rsheng1001-lang/WPT/LPspice_circuit/仿真结论_2026-09-21.md

# 输出端（接收端）恒流刺激电路 仿真结论

日期：2026-09-21
对象：`SCH_接收端原理图_2026-09-20.pdf`（v1.0，2026-09-20 版）中 V_BUS 之后的整条链路
仿真环境：LTspice 26.0.2，Windows；模型：TI OPAx333（原厂）、Diodes 2N7002（原厂）、
ST715/MCP1703AT/TVS（**自制近似模型，非原厂**）

一键复现：`cd ltspice && python run_all.py`

---

## 一、结论摘要

| 项目 | 结果 | 依据 |
|---|---|---|
| 恒流值 | **I(R10) = 99.999 µA**，负载支路 99.782 µA | 4 个工作点 + 连续扫描 |
| 恒流合规范围（典型件） | 1 kΩ ~ **76.7 kΩ**，即负载电压 ≤ **7.66 V** | `.dc` 连续扫描 |
| 恒流合规范围（计 FB 容差） | **73 k ~ 80 kΩ**（见第六节） | 数据手册 + 本仿真 |
| 合规边界所需压降 | 漏极余量 ≈ **0.345 V**（含 0.3 V 采样压降，即 Vds ≈ 45 mV） | 同上 |
| 跌出调节后的行为 | 恒压"饱和"：78.7 kΩ→98.2 µA，80 kΩ→96.5 µA，100 kΩ→78.0 µA | 同上 |
| 栅极驱动需求 | 100 µA 需 **2.478 V**，OPA333 实测最高输出 **3.271 V** | `.op` |
| 栅极驱动余量（最坏情况实测） | 仍余 **0.354 V**：Vth=2.5 V（规格上限）+ 3.3 V 轨下限 3.2 V 下仍正常恒流 | `core_gate_margin.cir` |
| 失效点 | **Vth ≈ 2.86 V**（实测 Vth=3.0 V 时电流只有 50.5 µA，即目标的一半） | `core_gate_cliff.cir` |
| 恒流值与 3.3 V 轨的关系 | **成比例**：I = V3V3/(11×3k)。轨压 3.2 V 时实测 96.97 µA（不是 100 µA） | 同上 |
| 上电行为 | **无电流过冲**（全程峰值 99.81 µA vs 终值 99.78 µA），10.2 ms 内进入 ±1% | 启动瞬态 |
| 母线总电流 | V_BUS=12 V 时 **164.8 µA**：灌电流 99.8 µA + 偏置 65.0 µA | 全母线扫描 |
| 8 V 轨起调点 | V_BUS ≥ **≈8.01 V** 起稳压（近似模型） | 全母线扫描 |
| 负载突变电流冲击 | 峰值 **634 µA（额定的 6.4 倍）**，但只持续 **0.5 µs**；净电荷偏差 < 0.6 nC | 负载阶跃 |

**总线电流自洽校验**：164.8 − 99.8 = 65.0 µA 偏置，与数据手册静态电流逐项相加
（FB 分压 12.0 + ST715 静态 3.8 + MCP1703 静态 2.0 + 核心分压 30.0 + OPA333 静态 17.0
= 64.8 µA）闭合到 0.2 µA。这是对网表和模型的一次独立交叉验证。

---

## 二、必须先说的：原厂 OPAx333 模型的求解器陷阱

这是上一轮工作卡住的地方，也是**使用本仿真结果前必须知道的前提**。

TI 的 OPAx333 宏模型是 Green-Williams-Lis 架构的电流模式网络，内部含开关（S 元件）、
TΩ 级节点（如 `R_R53 VCC_CLP MID 1T`）和巨大的跨导。它的直流方程组**存在多个解**，
其中一部分是物理上不可能的解（输出跑到供电轨之外）。实测：

| 求解路径 | V(OUTA) | V(I_SENSE) | 判断 |
|---|---|---|---|
| Gmin stepping 回退 | −5.21 V（低于 0 V 轨） | −0.0016 V | 伪解 |
| 冷启动 Newton | +8.51 V（高于 3.3 V 轨） | 1.75 V | 伪解 |
| 纯 Newton / 伪瞬态 | **2.480 V** | **0.300 V** | 物理解 |

三处具体后果，均已修正：

1. **`solver.inc`（新增）**：所有 deck 统一加 `.options gminsteps=0 srcsteps=0`，
   禁用 Gmin/source stepping 回退。回退注入的泄漏电流会把这颗模型的内部参考节点推偏。
2. **`.op` 负载表上限**：负载 ≥ 约 66 kΩ 时冷启动 `.op` 会落到伪解，因此
   `core_op.cir` 只保留 1k/10k/50k/65k 四个可信工作点；合规边界改用
   `.dc` 连续扫描（从 1 kΩ 起扫保证沿物理支路）在 `core_compliance.cir` 中测量。
3. **启动瞬态时长**：模型内部把参考节点挂在 `C_C14 = 5 µF` 对两个 1 MΩ 电阻上，
   时间常数约 **2.5 s**。因此 30 ms 的瞬态报出的是"内部参考尚未建立"的状态
   （这正是一度看到 V(OUTA) = −4.8 V 的原因），启动分析必须跑到 3 s。

**因此：任何用这颗模型得到的结果，都必须过一遍物理校验**（输出在供电轨内、
V(I_SENSE) = V(I_SET)、KCL 闭合）。本次所有结论都做了该校验。

---

## 三、文件结构

**要"看"电路，打开这两张图（LTspice 双击即可运行）：**

| 文件 | 内容 | 对应网表 |
|---|---|---|
| **`ltspice/full_bus.asc`** | 全链路 6 个模块，用**原厂** OPAx333 / 2N7002 + 自制近似稳压器 | `full_bus_dc.cir` |
| **`ltspice/sink_vendor.asc`** | 只有恒流沉三块，配理想 8 V/3.3 V 源 | `core_op.cir`、`core_startup.cir`、`core_reconnect.cir` |

不便开 LTspice 时可先看 `ltspice/preview/*.svg`（浏览器打开）。
顶层 `README.md` 有目录说明与一键复现方法。

```
输出端原理图/
  README.md                从哪开始、一键复现
  仿真结论_2026-09-21.md   ★ 本报告
  SCH_接收端原理图_2026-09-20.pdf   源图（嘉立创EDA v1.0）
  ltspice/
    full_bus.asc  sink_vendor.asc   ★ 原理图
    *.asy                           子电路符号（须与 .asc 同目录）
    *.net                           图导出的网表（LTspice 生成）
    decks/                          网表 deck（9 个 .cir）
      opa333_validation.cir    1. 原厂模型资格验证
      core_op.cir              2. 恒流沉直流工作点
      core_compliance.cir      3. 合规曲线（行为负载，连续扫描）
      core_startup.cir         4. 冷启动瞬态
      core_reconnect.cir       5. 负载阶跃瞬态
      full_bus_dc.cir          6. 全母线直流扫描
      core_gate_margin.cir     8. 栅极驱动最坏情况（Vth=2.5V，3.3V 轨下限）
      core_gate_cliff.cir      8. 同上但 Vth=3.0V（对照，应失效）
      tvs_compare.cir          8. TVS 近似模型 vs Vishay 官方库
    inc/                            sink / core / power / solver.inc
    models/                         OPAx333.LIB、2N7002_DIODES.lib（原厂）
                                    APPROX_NOT_VENDOR.lib（自制近似）
                                    2N7002_VTO25/VTO30.lib（Vth 敏感性变体）
    tools/                          make_schematic.py、compare_netlists.py、
                                    run_all.py、run_one.py、read_raw.py
    runs/                           仿真输出（.raw/.log/.db）
    preview/                        原理图预览 SVG
    summary.txt                     run_all.py 输出留档
  vendor/                  第三方资料：Vishay SPICE 库、数据手册、OPA333 原厂模型
  archive/                 早期 PDF 渲染截图
  self/                    你自己的草稿与下载（未纳入本工程）
```

一键复现：`cd ltspice && python tools/run_all.py`（跑 8 节，输出同时写入
`summary.txt`）。

### 原理图是怎么画和怎么验证的

上一轮只交付了网表（`.cir` 是纯文本，打开只能看到文字），本机也没有留下除
`Draft2.asc` 以外的图形文件。本轮补上了两张图，并做了三重验证：

1. **几何自检**（`make_schematic.py` 内置 + LTspice MCP 的 `verify_circuit`）：
   引脚是否落在导线上、有无悬空线头、导线是否穿过器件本体、有无意外交叉。
2. **网络一致性**：把图导出成权威网表，逐器件核对节点连接。
3. **数值等价**：跑图，把结果与 `.cir` 的结果逐个数字比对 ——
   `sink_vendor.asc` 相对误差 **9.7e-9**，`full_bus.asc` 全 49 个扫描点
   最大相对误差 **3.4e-7**（纯浮点噪声），即两张图与网表**是同一个电路**。
   这一步是必需的：第 1、2 步都查不出下面第 2 条的短路。

画图过程中被上述检查抓出并修正的错误（前两条会导致电路不等价）：

| # | 错误 | 后果 | 发现方式 |
|---|---|---|---|
| 1 | 生成 `OPAx333.asy` 时按 `SYMATTR Description` 截断文件，而 opamp2 的 PIN 定义在 Description **之后** | 运放符号没有引脚，四处悬空 | `verify_circuit` 报 dangling_wire_end |
| 2 | C13 的接地引脚落在 R8→STIM_GATE 导线的**内部**（同为 y=652，x=856 落在 840..904 之间） | **把栅极短路到地**，`STIM_GATE` 变成节点 0 | 数值比对（`V(stim_gate)` 消失、多出 `V(n001)`）；`verify_circuit` 不报此项，故自建检查器 |
| 3 | 移动后的 C13 本体框与 R_BONE→漏极的 BONE_N 导线重叠 | 仅视觉遮挡，电气无影响 | `verify_circuit` 报 wire_through_symbol |

**版式（2026-09-21 重排，按 PDF 分模块）**：两张图都按原 PDF 的功能划分画成
**6 个带边框的模块**，模块之间只用网络标签连接（PDF 也是这么画的）。
按要求**不放任何文字标注**（模块标题与说明段均已删除）：LTspice 按字节读 `.asc`，
非 ASCII 文字会显示为乱码，且会进入网表。

| 模块 | 内容 | 图 |
|---|---|---|
| 1 无线能量接收、补偿与整流滤波 | **未建模**（缺线圈与激励参数）：只有 V_BUS 激励源与 C5/C6 | 全链路 |
| 2 BONE 8V 稳压 | ST715 + R1/R2/R3 反馈 + C7/C8 + TVS D5 | 全链路 |
| 3 3.3V 参考电压 | MCP1703 + C9/C10 + R4（PGND↔GND 网络连接） | 全链路 |
| 4 恒流调节 | R5/R6/R7 + C12 | 两张 |
| 5 恒流控制 | OPA333 + C13/C14 + R8 | 两张 |
| 6 BONE负载 | Q1 + R9 + R10 + R_BONE | 两张 |

`full_bus.asc` 上排 1/2/3、下排 4/5/6；`sink_vendor.asc` 只含 4/5/6 并把理想
电源画进对应模块。

排布依据 LTspice 的实际行为（都是踩过坑才确认的）：

- **网络标签的文字方向跟随导线方向**——挂在竖直引脚上的标签会渲染成竖排文字。
  因此所有电源标签（V3V3 / PGND / BONE_P / BONE_N）都改走**水平短线**。
- **引脚画在方块外面时，引脚名会沿引脚方向旋转**。LTspice 自带的 `NE555.asy`
  把方块引脚放在方块边线上（零长度），引脚名就在方块内横排——本工程的方块符号
  改成同样写法。
- 水平电阻显式加 `WINDOW`（位号在上、阻值在下），因为 LTspice 默认会把两者叠在一起。
- **图必须写 `.save`**：不写的话 LTspice 会把宏模型的全部内部节点存进 `.raw`，
  一次 49 点的 `.dc` 扫描写出 156 MB、耗时 70 秒（写成 5 KB / 3 秒）。
- **`R_BONE` 要画在电流路径上**：它是骨/电极负载（BONE_P→组织→BONE_N），
  早期版本两端只用网络标签连接，看起来不像串在回路里；现在用实线从 BONE_P
  经 R_BONE 接到 MOSFET 漏极，只留一个 BONE_N 标签。
- **`.asc` 用 GBK 写，不用 UTF-8**：LTspice 按字节读 `.asc`，UTF-8 的中文会被
  当成多个字节写进网表并导致解析失败（实测报
  `Expected device instantiation or directive here`）。现已删除全部文字标注，
  但生成器仍按 GBK 写出，便于日后需要时再加文字。

**新增 `compare_netlists.py`**：把图导出的网表与 `.cir` 逐元件、逐节点比对。
数值等价只能说明"有差异"，这个工具能指出"差在哪个器件"。它在本轮抓出两处真错误：

| 错误 | 后果 | 发现方式 |
|---|---|---|
| 重排时漏掉 C5、C6、D5（TVS）三个器件 | 电路不完整 | 数值比对（相对差 6e-5） |
| **C5 的 PGND 短线与 C6 的 V_BUS 短线共线交叠** | V_BUS 与 PGND 短路（网表里 `VBUS PGND PGND`） | `compare_netlists.py` |

`make_schematic.py` 的几何自检也补上了"共线交叠"这一条。

**关于偶发不收敛**：同一份未改动的网表，正常 2 秒跑完，偶尔会走到伪瞬态支路后
步长崩塌、几分钟不推进（实测 `core_reconnect.cir` 一次 300 秒超时、随后三次复跑
均在 2 秒内完成且结果完全一致）。这是原厂宏模型直流求解的固有脆弱性，
`run_all.py` 现在会重试并在放弃时明确标注用的是哪一次的结果。
（另有一次 `full_bus.asc` 跑到 70 秒 / 156 MB，原因不同：那张图当时没写 `.save`，
与模型无关，已修正。）

### 本轮对上一轮文件的修正

| 文件 | 问题 | 处理 |
|---|---|---|
| `power.inc` | `R4 PGND 0 0` —— LTspice 拒绝字面 0 Ω，导致 `full_bus_dc.cir` **从未成功运行过** | 改为 1 mΩ 并注明图中原值就是 0 Ω（PGND↔GND 网络连接），压差为 µV 级 |
| `core.inc` | 负载与核心耦合在一个文件里，无法替换负载夹具 | 拆为 `sink.inc` + 负载，`core.inc` 保留兼容 |
| `core_op.cir` | 负载表含 ≥70 kΩ 点，冷 `.op` 报伪解 | 限制到可信区间，注明原因 |
| `core_startup.cir` | 30 ms 时长，报出未建立的内部参考状态 | 改为 3 s，并注明模型限制 |
| 各 deck | 继承伪解 | 统一加 `solver.inc` |

---

## 四、与原理图的逐点核对

已用 400 dpi 重渲染 PDF 并逐区放大核对，网表与图**完全一致**，包括容易搞错的几处：

- C14 = **100 pF**，跨接 OUTA ↔ I_SENSE（反馈电容，不是 100 nF）
- C13 = 100 nF（+3.3 V 去耦）、C12 = 100 nF（I_SET 滤波）
- R9 = 10 MΩ 接在 **STIM_GATE ↔ I_SENSE**（栅-源），不是栅-地
- Q1 = 2N7002：D→BONE_N，G→STIM_GATE，S→I_SENSE（与 Diodes 模型 `D G S` 顺序一致）
- U3 = OPA333AIDBVR：pin3=IN+←I_SET，pin4=IN−←I_SENSE，pin5=+3.3V，pin2=GND
- U1 = ST715CR：R1=560k / R2=6.8k / R3=100k，FB 取 R2-R3 中点 → 标称 8 V
- U2 = **MCP1703AT-3302E/CB**（不是 MCP1700A），VIN←BONE_P
- D5 = VESD16C1-02V-G3-08：阴极接 V_BUS、阳极接 PGND（反向击穿钳位，方向正确）
- 恒流设定：R5=100k / R7=10k → V(I_SET)=0.3 V，采样 R10=3 kΩ → **100 µA** ✓

---

## 五、各 deck 结果

### 1. `opa333_validation.cir` —— 原厂模型资格验证
单位增益跟随器，输入 0.1~3.2 V 直流扫描，最大 |V(out)−V(in)| = **0.336 µV**
（即模型的输入失调）。结论：模型在 LTspice 中的**差分行为正确**。
注意这一项**不能**证明直流支路唯一性（见第二节），两者互不替代。

### 2. `core_op.cir` —— 直流工作点

| RLOAD | I(R10) | V(I_SENSE) | V(OUTA) | V(BONE_N) | I(R_BONE) |
|---|---|---|---|---|---|
| 1 kΩ | 99.999 µA | 0.299998 V | 2.4798 V | 7.9018 V | 99.782 µA |
| 10 kΩ | 99.999 µA | 0.299998 V | 2.4798 V | 7.0038 V | 99.782 µA |
| 50 kΩ | 99.999 µA | 0.299998 V | 2.4798 V | 3.0125 V | 99.782 µA |
| 65 kΩ | 99.999 µA | 0.299998 V | 2.4798 V | 1.5158 V | 99.782 µA |

V(OUTA) 恒定 2.4798 V（因为 100 µA 所需的栅压与负载无关），全程在 0~3.3 V 轨内。
I(R10) 与 I(R_BONE) 相差 0.217 µA，正好等于流经 R9(10 MΩ) 的电流
（2.1776 V / 10 MΩ = 0.218 µA）—— **KCL 精确闭合**。

### 3. `core_compliance.cir` —— 合规曲线

| RLOAD | I(R10) | V(I_SENSE) | V(OUTA) | 状态 |
|---|---|---|---|---|
| 9.9 k ~ **76.7 kΩ** | **99.999 µA** | 0.299998 V | 2.4798 V | 恒流调节 |
| 78.7 kΩ | 98.203 µA | 0.294610 V | 3.2709 V | 饱和 |
| 80.2 kΩ | 96.456 µA | 0.289369 V | 3.2709 V | 饱和 |
| 90.1 kΩ | 86.232 µA | 0.258697 V | 3.2710 V | 饱和 |
| 100 kΩ | 77.978 µA | 0.233933 V | 3.2711 V | 饱和 |

边界点 V(BONE_N) = 0.3449 V → **负载电压上限 7.657 V**，即 100 µA 下
最大负载 76.7 kΩ。跌出调节后运放输出顶到 3.271 V（饱和），电流退化为
纯电阻限制 (V8 − 0.25)/(RLOAD + 3k)，这是"失效安全"的方向（电流变小）。

### 4. `core_startup.cir` —— 冷启动（RLOAD=10 kΩ，电源 1~2 ms 斜坡）

- 稳定值 99.782 µA；**全程峰值 99.814 µA，过冲仅 0.03%**
- V(OUTA) 全程 ∈ [−0.0051, 2.4799] V，未越轨
- 10.22 ms 内进入 ±1%
- 时序：V8 先到 8 V（1 ms），3.3 V 轨 2 ms 建立后环路才导通 → 上电期间
  负载上先出现 8 V 但**没有电流**，之后平滑爬升。**无上电电流冲击**。

### 5. `core_reconnect.cir` —— 负载阶跃（60 kΩ → 9.37 kΩ，t=5 ms）

- 阶跃前后均稳定在 99.782 µA
- **峰值 634.3 µA（6.4 倍额定）**，出现在阶跃后 0.51 µs
- 随后短暂反向：最低 −0.728 µA
- **超出 100 µA 的多余电荷仅 0.512 nC**；不足部分 4.361 nC
- 37.4 µs 内回到 ±2%，50 µs 后偏差 < 0.9 µA

即：电流冲击幅值高但极短，净电荷偏差 **亚 nC 级**（对比典型刺激脉冲 100 µA×100 µs
= 10 nC）。环路阻尼良好，无持续振荡。

### 6. `full_bus_dc.cir` —— 全母线（V_BUS 4~16 V，**近似**稳压器）

| V_BUS | BONE_P | +3.3 V | I_sink | I(V_BUS) |
|---|---|---|---|---|
| 4 V | 3.9991 V | 3.3000 V | 99.782 µA | −158.8 µA |
| 8 V | 7.9991 V | 3.3000 V | 99.782 µA | −164.8 µA |
| 8.5 V | 8.0016 V | 3.3000 V | 99.782 µA | −164.8 µA |
| 12 V | 8.0016 V | 3.3000 V | 99.782 µA | −164.8 µA |
| 16 V | 8.0016 V | 3.3000 V | 99.782 µA | −164.8 µA |

- 8 V 轨在 V_BUS ≥ ≈8.01 V 起稳压（近似模型压差仅 ~1 mV，真实 ST715 亦很小）
- 恒流值在整个 V_BUS 范围内不变
- 16 V 相对 12 V 的输入电流只多 2 nA → 近似 TVS 漏电可忽略

---

## 六、原厂模型 vs 近似模型（结论可信度分级）

| 器件 | 模型来源 | 可用于 |
|---|---|---|
| U3 OPA333 | **TI 原厂** | 直流、环路、瞬态（须过物理校验） |
| Q1 2N7002 | **Diodes 原厂** | 直流、开关 |
| U1 ST715CR | 自制近似 | **仅**连接性与直流可行性 |
| U2 MCP1703AT | 自制近似 | **仅**连接性与直流可行性 |
| D5 TVS | 自制近似 | **仅**连接性与直流可行性 |
| D1–D4 整流桥、C1–C4 补偿 | **未建模** | — |

---

## 七、官方模型可得性核查（2026-09-21）

| 器件 | 官方 SPICE 模型 | 证据 / 文件 |
|---|---|---|
| U1 ST715CR | **没有** | ST 该料号页面只有 "EDA Symbols, Footprints and 3D Models"（Ultra Librarian / SamacSys）。ST 的 SPICE 库（97 条）全是功率器件/运放，**没有任何 LDO**；抽查 6 个 ST LDO 产品页，"spice" 出现 0 次。ST 的仿真工具（eDSim/TwisterSim/TVS Simulator）均不覆盖线性稳压器。 |
| U2 MCP1703AT | **有** | Microchip **MPLAB Mindi "Analog Simulation"** 库：`MCP1703A-33_Startup.zip`、`MCP1703A-33_Transient.zip`（2020-08-17），共 16 个文件按输出电压分档。<br>`microchip.com/en-us/software-library/analogsimmcp1703a`<br>注意：**免登录但需过 EULA 点击**；格式是 **SIMetrix/SIMPLIS 工程**而非通用 `.LIB`；按输出电压分档、**不区分封装**。本机自动下载被 HTTP 403 拦截。 |
| D5 VESD16C1-02V | **部分有** | 精确的 **-02V（SOD-523）无模型**，该料号页面只有 Ultra Librarian 的符号/封装/3D。<br>但 Vishay 发布覆盖 `VESD16C1` 的**明文 SPICE 库**（文件头声明适用范围为 `-HD1`，即 SOD-323 封装）：<br>`vishay.com/docs/86547/spice_vishay_vesd01c1-hd1-to-vesd33c1-hd1.zip`（2022-02，已下载并核实，见 `ltspice/vendor/vishay/`）。<br>模型内容：`D1 1 2 DF`，`BV=17.7 V / IBV=10 µA / CJO=27 pF`，引脚 1=阳极、2=阴极。 |

**对本次结论的实际影响（已实测，见 `tvs_compare.cir`）**：
- **TVS 的直流结论不变**：12 V 工作点上漏电 近似模型 7.5 nA vs 官方模型 0.024 nA，
  相差 7.5 nA，只有母线电流（165 µA）的 **0.0045%** → 全部直流结论不受影响。
- **但钳位拐点不可互换**（这一条推翻了本报告上一版的说法）：官方模型 1 µA 出现在
  **17.75 V**、1 A 出现在 **18.5 V**；近似模型分别是 **18.0 V / 20.0 V**。
  19 V 下两者电流差 **4 倍**（0.53 A vs 2.09 A），等效钳位阻抗约 2.06 Ω vs 0.5 Ω。
  **做浪涌/ESD 分析必须用官方模型**；封装差异（库声明适用于 -HD1/SOD-323，
  板上是 -02V/SOD-523）仍需标注。
- **MCP1703A**：官方模型的价值在 **启动与负载瞬态**——正是现有近似模型不具备、
  也是本次报告明确标记"未验证"的两项。但它是 SIMetrix/SIMPLIS 工程，
  **不能直接喂给 LTspice**；正确做法是用免费的 **MPLAB Mindi** 单独跑这两项。
- **ST715**：任何来源都没有模型。这是硬缺口，只能靠实测或换料解决。

---

## 八、数据手册核对（不依赖模型的独立检查）

用 ST715 DS5704 Rev 16（2025-03）、MCP1703A DS20005122C 复核，发现 4 条与设计直接相关的条文：

1. **8 V 轨实际容差远大于仿真的 8.0016 V。** 可调版 FB 基准 V_FB 的容差为
   1.195~1.245 V（0~85 °C）/ 1.152~1.248 V（−40~125 °C），
   而 V_OUT = V_FB × (1 + 566.8k/100k) = 6.668 × V_FB。折合：
   - 0~85 °C：**7.97 ~ 8.30 V**
   - 全温区：**7.68 ~ 8.32 V**

   代入合规边界 V(BONE_N) = 0.345 V，100 µA 下最大负载相应为
   **73.4 k ~ 79.8 kΩ**（本报告第一节的 76.7 kΩ 是典型值）。
   （R1/R2/R3 自身容差与温漂会在此基础上再加。）

2. **ST715 可调版的精度规格只在 I_OUT ≥ 1 mA 下保证，本设计负载只有约 165 µA。**
   手册 Table 6 的 V_FB 精度与负载调整率**都带 1 mA 下限**；
   而**固定输出版（Table 7）是从 0 mA 起**给规格的。
   即：8 V 的精度落在保证范围之外——不是"已知不达标"，而是"未承诺"。
   建议按第 2 条实测轻载下的实际输出。

3. **C8 = 0.47 µF 正好卡在 ST715 输出电容的下限。** 手册要求 C_OUT ≥ 0.47 µF
   （"from 0.47 µF to 10 µF"），无余量；且 Figure 9 的稳定性区域图里，
   低 ESR 陶瓷电容在 0.47 µF 处落在 "Untested area"。
   建议加大到 1 µF 以上再评估。

4. **U2 的输入/输出电容比例不符合手册建议。** MCP1703A 要求
   "C_IN 应 ≥ C_OUT"（用于动态负载时给输出电容补能），且典型应用建议 C_IN = 1 µF。
   本设计 C9 = 100 nF、C10 = 1 µF（C10 本身合规：1~22 µF 陶瓷范围的下限）。
   虽然手册允许负载 < 100 mA 时降低 C_IN，但建议把 C9 提到 1 µF。
   另：MCP1703A 输出上升时间 600 µs 典型且"controlled to prevent overshoot"，
   支持 3.3 V 轨无上电过冲的判断。

（输入电容 C7 = 100 nF 与 ST715 手册推荐的 0.1 µF 及特性化条件一致，无需改动。）

---

## 九、本次仿真**不能**得出的结论（明确边界）

1. **无线供电性能**：接收线圈电感/电阻、工作频率、激励参数从未提供，整流前端
   （D1–D4、C1–C4、C5/C6）未建模，`full_bus_dc.cir` 从 V_BUS 起算。因此
   **不能**得出接收功率、效率、V_BUS 建立时间等任何结论。
2. **稳压器性能**：ST715/MCP1703 是自制近似模型，**没有**环路稳定性、启动过冲、
   PSRR、过流/过温保护、反向电流保护等行为。带真实模型前不能判定 LDO 稳定性。
3. **真实电极负载**：RLOAD 是测试电阻。真实电极-组织界面有容性分量，
   高频阻抗远低于电阻模型；脉冲边沿行为需实际阻抗模型。
4. **温度、容差、批次**：无温度扫描、无容差/Monte Carlo 分析。特别是栅极驱动余量
   0.79 V 依赖 Vth ≤ 2.95 V，建议对 Vth 上限件做实测确认。
5. **ESD/浪涌**：TVS 近似模型不是经验证的 ESD 模型，不能用于 ESD 等级判定。
   换用 Vishay 官方 VESD 库后可以先做连接性/钳位分析，但该库声明适用于
   `-HD1`（SOD-323）封装，与图上的 `-02V`（SOD-523）不同封装，浪涌行为仍不可断言。
6. **启动仿真限制**：负载 ≥ 约 50 kΩ 时该原厂模型的 t=0 工作点本身即伪解，
   瞬态无法推进，故重载启动未报告。
7. **LDO 的启动与负载瞬态**：Microchip 官方模型（`MCP1703A-33_Startup/Transient`）
   存在但为 SIMetrix/SIMPLIS 工程，未纳入本次仿真；ST715 无任何模型。

---

## 十、最坏情况与模型替换核查（2026-09-21 补充）

| 检查 | 方法 | 结果 |
|---|---|---|
| 栅极驱动最坏情况 | `core_gate_margin.cir`：MOSFET Vth 取数据手册上限 2.5 V，3.3 V 轨取下限 3.2 V，逐负载独立 `.op` | **仍正常恒流**：V(I_SENSE) 与 V(I_SET) 相差 0.6 µV，V(OUTA)=2.8167 V，距运放上限 3.171 V 还有 **0.354 V** |
| 失效边界（对照） | `core_gate_cliff.cir`：同上但 Vth=3.0 V（超出规格） | **不恒流**：电流只有 50.5 µA，V(OUTA) 顶到 3.171 V（栅极驱动耗尽） |
| 由此外推 | — | 本设计可容忍 Vth 高至约 **2.86 V**，高于 2N7002 规格上限 2.5 V |
| TVS 模型替换 | `tvs_compare.cir`：近似模型与 Vishay 官方库并排扫 0~25 V | 漏电 7.5 nA vs 0.024 nA（直流结论不变）；钳位拐点 17.75/18.5 V vs 18.0/20.0 V（**不可互换**） |

MOSFET 的 Vth 变体（`models/2N7002_VTO25.lib`、`_VTO30.lib`）是**敏感性分析用的变体，
不是厂商模型**：只改了 VTO，其余文本与 Diodes 原厂模型逐字相同，文件头已声明。

**一个独立发现**：恒流设定值是从 3.3 V 轨分压得到的，因此
**I_out = V3V3 / (11 × 3 kΩ)**——电流与 3.3 V 轨成比例，没有独立基准。
实测：轨压 3.3 V → 100.0 µA；轨压 3.2 V → 96.97 µA。
即电流精度 = LDO 输出精度 + R5/R6/R7/R10 容差。若需要更准的刺激电流，
应把 I_SET 改为由独立基准（如 OPA333 之外的基准源）产生，而不是取自 3.3 V 轨。

---

## 十一、建议的下一步

1. **实测 ST715CR 在 ~165 µA 轻载下的 8 V 实际输出与启动波形。** 这是唯一能闭合
   的项目：可调版的精度规格（V_FB、负载调整率）只保证 I_OUT ≥ 1 mA，
   而本设计负载低一个数量级，无模型可依（见第八节第 1、2 条）。
2. **电容两处调整**：C8 由 0.47 µF 提到 ≥1 µF（现正好卡在 ST715 下限且落在
   手册稳定性图的 "Untested area"）；C9 由 100 nF 提到 1 µF（MCP1703A 要求
   C_IN ≥ C_OUT）。
3. **用免费的 MPLAB Mindi + Microchip 官方模型单独跑 MCP1703A 的启动与负载瞬态**，
   可闭合现在标记为"未验证"的 3.3 V 轨软启动（手册标称 600 µs、无过冲）。
4. **合规上限按 73~80 kΩ 规划**（不是仿真给出的 76.7 kΩ 典型值），
   或在固件/硬件上限制最大负载电压 ≤ 7.6 V。
5. 提供接收线圈参数与激励，才能把整流前端纳入仿真。
6. 用实测电极阻抗替换 RLOAD 复跑第 3、5 节。
7. Vth 上限件（2.5 V）实测栅压需求，确认 0.79 V 余量。
8. 若做浪涌/ESD 分析，换用已下载的 Vishay 官方 VESD 库
   （`ltspice/vendor/vishay/`），并标注封装差异。
