rsheng1001-lang/WPT/self_LPspice/bone_sweep_analysis/figures/fig4_rmax_heatmap.pdf

## a Maximum BONE load, Rmax (kΩ), at a ±1.5 % budget

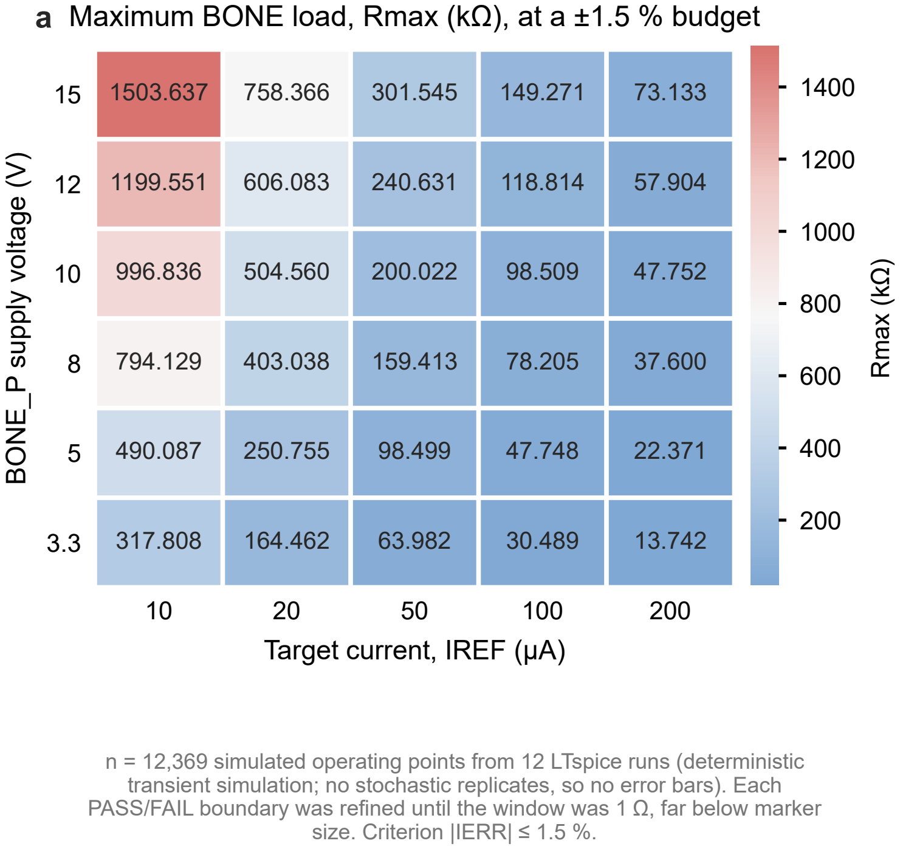
[picture p6: page 1]

10 | 20 | 50 | 100 | 200

### Target current, IREF (µA)

15

12

10

8

5

3.3

### BONE_P supply voltage (V)

1503.637 | 758.366 | 301.545 | 149.271 | 73.133
1199.551 | 606.083 | 240.631 | 118.814 | 57.904
996.836 | 504.560 | 200.022 | 98.509 | 47.752
794.129 | 403.038 | 159.413 | 78.205 | 37.600
490.087 | 250.755 | 98.499 | 47.748 | 22.371
317.808 | 164.462 | 63.982 | 30.489 | 13.742

200

400

600

800

1000

1200

1400

Rmax (kΩ)

n = 12,369 simulated operating points from 12 LTspice runs (deterministic transient simulation; no stochastic replicates, so no error bars). Each PASS/FAIL boundary was refined until the window was 1 Ω, far below marker size. Criterion |IERR| ≤ 1.5 %.
