rsheng1001-lang/WPT/self_LPspice/bone_sweep_analysis/README.md

# BONE_P 恒流源 — LTspice 三参数扫描分析（判据 ±1.5%，30/30 组合已精细定界）

本文件夹是 `Draft2` 三参数扫描（VBP × IREF × RB）的完整分析产物，与 LTspice 工程文件分离存放。
原始仿真输出（日志、网表、波形）归档在同级的 `../runs_archive/`，机制见文末「关于日志被覆盖」。

## 目录结构

```
bone_sweep_analysis/
├── Draft2_BONE_sweep_analysis.xlsx   ← 最终交付：8 个工作表 + 7 张图表（全部扫描合并）
├── README.md                          ← 本文件
├── scripts/                           ← 流水线
│   ├── ingest.py                      ★ 自动抓取新扫描入库（跑完直接一条命令）
│   ├── refine.py                      ★ 循环精细化扫描（自动改 RB 区间/步长 → 跑 → 入库 → 收敛）
│   ├── archive_run.py                 ★ 把一次运行的全部输出（含 .raw 波形）归档到 ../runs_archive/
│   ├── build_xlsx.py                  生成 Excel（公式 + 条件格式 + 图表）
│   ├── verify_xlsx.py                 用 Excel 重算并逐格比对真值，导出图表 PNG
│   ├── check_delivered.py             直接审计交付 .xlsx 的 XML
│   ├── parse_sweep.py                 通用解析器（ingest.py 内部复用）
│   ├── parse_draft2.py / parse_sweep2.py   历史脚本（早期单次解析）
│   ├── merge_sweeps.py                历史脚本（早期合并；现由 ingest.py 承担）
│   └── analyze_draft2.py              控制台版分析（Rmax / 临界区 / 10 µA）
├── work/                              ← 数据仓库
│   ├── manifest.json                  已入库扫描的登记表（签名 / 日志快照 / 统计）
│   ├── sweeps/sweep_<签名>.json        每次扫描的解析结果（永久保存）
│   ├── logs/<时间戳>_<日志名>.log      每次扫描的**原始日志快照**
│   ├── parsed_combined.json           所有扫描的并集（按 VBP→IREF→RB 排序，去重）
│   └── ground_truth.json              独立真值 + 表格布局行号（供校验）
├── charts/                            ← Excel 内嵌图表的 PNG 导出（7 张，工作簿用）
├── figures/                           ← ★ 出版级图表（nature-figure 技能产出）
│   ├── fig1_rmax_design_rule.{svg,pdf,tiff}    设计规则 + 验证（3 面板）
│   ├── fig2_compliance_limit.{svg,pdf,tiff}    ±1.5% 顺从极限（6 面板，按电源轨）
│   ├── fig3_transfer_characteristic.{svg,pdf,tiff}  原始传输特性（6 面板）
│   ├── fig4_rmax_heatmap.{svg,pdf,tiff}        Rmax 查找矩阵（单栏 89 mm，热力图）
│   ├── fig_source_rmax.csv            Fig.1 源数据
│   ├── QA_NOTES.md                    图契约、统计口径、QA 链结果、已修缺陷记录
│   └── make_figures.py                绘图源码
├── archive/                           ← 上一版（仅扫描 A）的工作簿，留档
└── restore/                           ← 2026-09-21 模型恢复过程与验证记录
    └── RESTORE_NOTES.md
```

## 三次扫描

| | 日志 | RB 范围 | 步长 | 分辨率 | 组数 | PASS=1 |
|---|---|---|---|---|---|---|
| **A** | `../Draft2.log` | 10 kΩ … 200 kΩ | 1 kΩ（191 点） | **1 kΩ** | 5730 | 2628 |
| **B** | `../Draft2_sweep.log` | 200 kΩ … 1000 kΩ | 10 kΩ（81 点） | **10 kΩ** | 2430 | 169 |
| **C** | `../Draft2_sweep.log` | 1 MΩ … 10 MΩ | 100 kΩ（91 点） | **100 kΩ** | 2730 | **0** |
| **refine ×9** | `refine.py` 生成 | 各临界窗口 | 1 kΩ→100 Ω→10 Ω→1 Ω | 逐轮收紧 | 1881 | — |

> refine 系列共 9 条记录（先按 1% 判据收敛 24 个窗口，改判据后又把 30 个窗口各收敛一轮）。
> 当前共 **12 条扫描记录、12369 行、1828 个 RB 取值**。

其余指令各次相同：`IREF list 10u 20u 50u 100u 200u`、`VBP list 3.3 5 8 10 12 15`、
`.tran 15m startup`，稳态测量区间 **12 ms ~ 15 ms**。

**重叠点交叉验证**：A/B 在 200 kΩ、B/C 在 1 MΩ 处重叠。两个重叠点各 30 个组合逐点比对，
IBONE 与 IERR **逐位完全一致**（最大相对偏差 0.00e+00）——证明三次运行是同一电路、同一模型。
重叠点合并时只保留一行（取自较早的扫描）。合并后 **12369 组**，1828 个 RB 取值，
无缺失、无重复。

## 日常流程（新扫描跑完后）

LTspice 每跑完一次，直接：

```bash
cd scripts
python archive_run.py     # 先归档：波形/网表/日志整个搬进 ../runs_archive/（幂等）
python ingest.py          # 自动找最新的完整日志 → 抓取入库
python build_xlsx.py      # 更新 Excel
python verify_xlsx.py     # 重算 + 逐格校验（可选，但建议）
```

**`archive_run.py` 放在第一步**：它会把这次运行的 `.log/.net/.raw/.op.raw/.db/.asc` 整体归档，
其中 `.raw` 默认是**移动**（工程根目录不再保留，LTspice 下次运行会重新生成）。换扫描参数前跑一次，
就再也不会出现扫描 B 那种"波形被下一次运行覆盖"的损失。细节见 `../runs_archive/README.md`。

`ingest.py` 会自动完成：

1. **自动挑选**工程目录里最新的日志（也可 `python ingest.py <路径>` 指定）；
2. **判断是否跑完**：四个 `.meas` 段齐全、行数等于 `.step` 行数、且文件静置 20 s 以上
   （没跑完就拒绝入库并提示）；
3. **校验**：step↔measurement 配对（用 `VBONE/IBONE` 反算 RB）、`PASS == (IERR<=1)`、
   组合无重复无缺失；
4. **快照原始日志**到 `work/logs/`，把解析结果存到 `work/sweeps/`，登记进 `work/manifest.json`；
5. 若该扫描**已入库**（按"实际跑过的 (VBP,IREF,RB) 集合"的签名判定），会逐位比对并刷新，
   **不会产生重复行**；
6. 重建 `work/parsed_combined.json`（所有扫描的并集）。

之后 `build_xlsx.py` 会自动把新扫描纳入：`Raw_Data` 增加 `Sweep`/`Source_Log` 列标注来源、
README 页自动列出每次扫描、图表自动扩展到新数据范围——**无需改代码**。

`python ingest.py --list` 可查看当前已入库的扫描清单。

### 为什么不用你管文件名

日志里的 `.step` 行是**每次运行的展开值**（几千行），真正的 `.step` 指令只存在于 `.net` 里。
所以入库身份用的是"这次实际跑了哪些 (VBP, IREF, RB)"的签名，与文件名无关；
每次抓取还会把原始日志**快照**下来，因此后续同名日志被覆盖也不影响已入库的数据。

## 判据阈值（可配置）

PASS 是 `IERR` 的纯函数，而 IERR 已按全精度存库，所以**改阈值不需要重跑任何仿真**。

| 位置 | 作用 |
|---|---|
| `scripts/config.py` → `IERR_MAX_PCT` | 决定 `refine.py` 的边界定位与写入工作簿的阈值 |
| 工作簿 `Rmax_Summary` 的「PASS 判据 IERR ≤ (%)」单元格 | `Raw_Data` 的 PASS 列是引用该格的活公式，改这一格全表重算 |

**当前阈值 ±1.5%。** 注意 LTspice 网表里的 `.meas PASS` 仍是 1% 判据（保留作为 IERR
解析正确性的校验），因此 `Raw_Data` 的 PASS 列与日志自身的 PASS 可能不同——工作簿 README
页 §4 已写明。改阈值的动作：改 `config.py` → `ingest.py` → `refine.py`（重新收敛边界）
→ `build_xlsx.py` → `verify_xlsx.py`。

## 精细化扫描（refine.py）

粗扫把每个临界值定位到当时扫描的分辨率（低阻段 1 kΩ、高阻段 10 kΩ）。`refine.py` 自动把它
收敛到工程可用的精度：

```bash
cd scripts
python refine.py                  # 目标：每个窗口 <= 10 Ω（默认）
python refine.py --target 1       # 更细：1 Ω（本次已跑到这一级）
python refine.py --parallel 6 --points 11 --max-rounds 6
```

每一轮它做四件事：

1. 从已入库数据算出每个 (VBP,IREF) 的 `lastPASS`/`firstFAIL` 窗口；
2. 对窗口仍大于目标的组合，**自动改 RB 区间与步长**（11 点等分窗口）并生成一个 deck；
3. 并行调用 `LTspice.exe -b` 跑完，解析日志、校验后**入库**（每轮成为 manifest 里的一条扫描记录）；
4. 重新定位窗口，继续下一轮，直到全部收敛。

实测：24 个临界窗口 × 11 点 = 264 组，**约 10 秒**跑完一轮。

**结论：24/24 收敛到 1 Ω**（相对约 100 kΩ 即 0.001%）。且每个 `lastPASS` 处的 IERR 都在
0.99%~1.00%，说明收敛到的正是 ±1% 阈值的真实交点。

### 踩过的两个坑（写在这里避免重复）

- **LTspice 26 不接受单值 `.step`**：`.step param IREF list 20u` 会报
  "This results in only one step" 并以退出码 1 终止、不产生任何输出。
  精细化 deck 因此把 IREF/VBP 用 `.param` 固定，**只对 RB 做 `.step`**。
- 这些 deck 的日志里只有 `.step rb=<值>`，没有三参数形式，所以 `refine.py` 用专门的
  解析路径（step 顺序 = RB 顺序），不能直接套用整扫的解析器。
## 出版级图表（figures/，nature-figure 技能）

```bash
cd figures
PYTHONPATH="<nature-figure>/scripts" python make_figures.py   # 重画并跑对齐门
# 然后按 QA_NOTES.md 里的命令跑字形下限与碰撞审计
```

四张图，可编辑文本，SVG + PDF + TIFF(600 dpi)：

| 图 | 内容 | 面板角色 |
|---|---|---|
| Fig. 1 | 设计规则 | a 主图 Rmax vs 电源电压；b 与解析式的 parity 验证；c 公式失效边界（10 µA） |
| Fig. 2 | ±1.5% 顺从极限 | a–f 每个电源轨一张，预算虚线上用 ▼ 标出各电流的 Rmax |
| Fig. 3 | 原始传输特性 | a–f 每个电源轨一张（用户指定轴：电流 vs 负载电阻） |
| Fig. 4 | Rmax 查找矩阵 | a 热力图：行=电源电压、列=目标电流、格内为 Rmax（**3 位小数**），蓝-白-红发散色阶 + colorbar（单栏 89 mm）。**两轴均从小到大**（3.3 V 在底部、10 µA 在左侧） |

**QA 链（全部在最终渲染上通过）**：源预检 20 pass/1 warn/0 fail；对齐门 **PASS**×3
（Fig.4 单面板为 NOT APPLICABLE，符合契约）；字形下限 **PASS**×4（最小 5.6 pt）；
PDF 碰撞审计 **PASS**×4（0 fail/0 warn）；页面实测 183.0 mm ×3、89.0 mm ×1。
Fig.4 的单元格文字对比度实测 4.72–13.91:1（30 格全部 ≥4.5:1）；30 个格值与原始
last-PASS 电阻**逐个精确相等**（无四舍五入、无插值、无平滑）。唯一的 warn 是静态检查器读不出命名常量里的宽度，已用 PDF 实测澄清。

过程中修掉 9 个缺陷，其中**一个是真实的数据错误**：Fig.3 曾用 `IERR × IREF / 100` 反算电流，
而 IERR 是相对误差，导致差了 **732 倍**（曲线从 0 升起而非恒流平台）——这类错误只有逐面板目视
才能发现，自动化检查全部通过。详见 `figures/QA_NOTES.md`。

## ⚠ 关于日志被覆盖（已有对策）

三次扫描都从同一个 `../Draft2_sweep.asc` 运行，因此**每次运行都会覆盖**上一轮的
`Draft2_sweep.log/.raw/.net`。

- 扫描 B 的原始日志与波形数据（398 MB `.raw`）**已被扫描 C 覆盖，无法找回**；
  仅剩解析后的 2430 组数据（`work/sweeps/` 内）作为记录。这是唯一一次损失。
- 扫描 A 与 C 的原始日志**已快照**到 `work/logs/`（`ingest.py` 对每次入库的扫描自动做）。
- **扫描 A 与 C 的完整运行（含 926.7 MB / 428.1 MB 波形）现已归档**到
  `../runs_archive/`，不再受根目录覆盖影响。

**现在的机制**：`python scripts/archive_run.py` 把工程根目录里所有尚未归档的运行整个搬进
`../runs_archive/<时间戳>_<名字>_<签名>/`（日志、网表、原理图、工作点、`.db`、`.raw` 波形 +
`meta.json` 含每个文件的 sha256）。按"名字 + 日志 sha256"判重，**幂等**，重复执行无副作用；
未跑完的扫描（同一套完整性判据）会被拒绝归档。**换扫描参数前跑一次即可。**

归档时还会顺带核对一件本工程反复踩到的事：**旁边的 `.asc` 往往不是产生这份日志的那一版**
（LTspice 改指令不存盘时，`.asc` 留在旧版本而 `.net` 已是新的）。脚本会把 `.asc` 的指令与
`.net` 逐条比对，把结论写进 `meta.json`，并在能找到真正匹配的原理图时一并归档。
已归档的两次运行的结论都是"同名 `.asc` 不匹配"——**要复现某次运行，以归档里的 `.net` 为准。**

`refine.py` 生成的精细化 deck 不需要额外归档：它们本来就在 `refine/decks_<时间戳>/` 里每轮一个独立文件夹。

## 校验状态

- `verify_xlsx.py`：**775/775 项通过**（Excel COM 强制全量重算后与 Python 独立真值逐格比对，
  含 Rmax 矩阵、临界区、精度矩阵、图表系列数、条件格式、命名区域，以及保存后的结构复核）
- `check_delivered.py`：**PASS**（XML 层面的冻结窗格、自动筛选、2 条 PASS 条件格式、
  定点数字格式、公式缓存值均在）
- 解析匹配的独立证据：每行用 `VBONE/IBONE` 反算 RB，与日志 `.step` 的最大相对误差
  **4.8e-07（A）/ 6.2e-08（B）/ 5.9e-08（C）**
- 重叠点 A/B 与 B/C 各 30 组逐位一致（见上）

## 结果要点

**判据 ±1.5%：30/30 组合全部测得真实临界值，且全部收敛到 1 Ω 窗口。**

| BONE_P / V | 10 µA | 20 µA | 50 µA | 100 µA | 200 µA |
|---|---|---|---|---|---|
| 3.3 | 317.808 | 164.462 | 63.982 | 30.489 | 13.742 |
| 5 | 490.087 | 250.755 | 98.499 | 47.748 | 22.371 |
| 8 | 794.129 | 403.038 | 159.413 | 78.205 | 37.600 |
| 10 | 996.836 | 504.560 | 200.022 | 98.509 | 47.752 |
| 12 | 1199.551 | 606.083 | 240.631 | 118.814 | 57.904 |
| 15 | 1503.637 | 758.366 | 301.545 | 149.271 | 73.133 |

单位 kΩ，每个值的窗口为 1 Ω（约 0.001%）。

**收敛自检**：每个 `lastPASS` 处的 IERR 都落在 **1.4990%~1.5000%**、`firstFAIL` 处
1.5000%~1.5050% —— 说明 1 Ω 网格正好咬住 ±1.5% 的真实交点，不是数值噪声。

**推荐设计公式**：`Rmax ≈ VBP / ((1 − T/100) × IREF) − R10`（T = 阈值 %，R10 = 3 kΩ）

- 目标电流 **≥20 µA**：平均偏差仅 **0.015%~0.031%**，可直接用于设计
- **10 µA：该式失效**（平均 2.15%、最大 4.28%）—— 其低负载基础误差已达 1.30%，
  距 1.5% 只剩约 0.2% 余量，拐点几乎与顺从电压拐点重合，一阶模型不成立；此情形请直接用表中实测值
- 公式来历：边界处电流已跌落约 T%，负载可用电压由这个已跌落的电流决定，故 R = V/I
  比用 IREF 算大约 T%（1% 判据下该式把偏差从 0.985% 降到 0.063%）

## 需要注意的已知限制

- 临界值已在 1 Ω 窗口内收敛；**非临界区域仍是原始粗分辨率**（1 kΩ / 10 kΩ / 100 kΩ 分段），
  这是有意的——只有临界窗口需要精细定位。
- 10 µA 的 1.5% 判据余量极小（0.198%），其临界值对电路参数变化最敏感；
  若电路改动（如运放失调变化），10 µA 行会最先变化。
- 全程未对缺失点插值或补数；图表只连接真实仿真点。
- 本机 Excel 实测**不支持 MAXIFS/MINIFS**，公式已改用 `LOOKUP` / `SUMPRODUCT` 兼容写法。
- 扫描 B/C 由恢复的 `../Draft2_sweep.asc` **起步**运行；该原理图为**重建版**（网表已验证等价，
  见 `restore/RESTORE_NOTES.md`）。但运行时的 `.step` 指令是在 LTspice 内存里改的、**没有存盘**：
  磁盘上那张 `.asc` 至今写着 B 段的 `RB 10k 200k 1k`，而 C 段实际跑的 `.net` 是
  `RB 1Meg 10Meg 100k`。**要复现某次运行，以 `../runs_archive/` 里对应文件夹的 `.net` 为准**
  （归档时已逐条比对并记录在 `meta.json` 的 `schematic` 段）。

详细说明（数据来源、判据定义、失效机理、验证结果）见 xlsx 的第一个工作表 `README`。
