rsheng1001-lang/WPT/FPC线圈叠层图/inputs/GND/GND.pdf

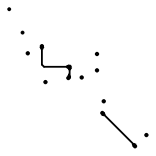
[picture p7: figure]
