rsheng1001-lang/WPT/FPC线圈叠层图/inputs/POWER/POWER.pdf

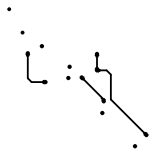
[picture p8: figure]
