rsheng1001-lang/WPT/FPC线圈叠层图/inputs/板框/Multi-Layer.pdf

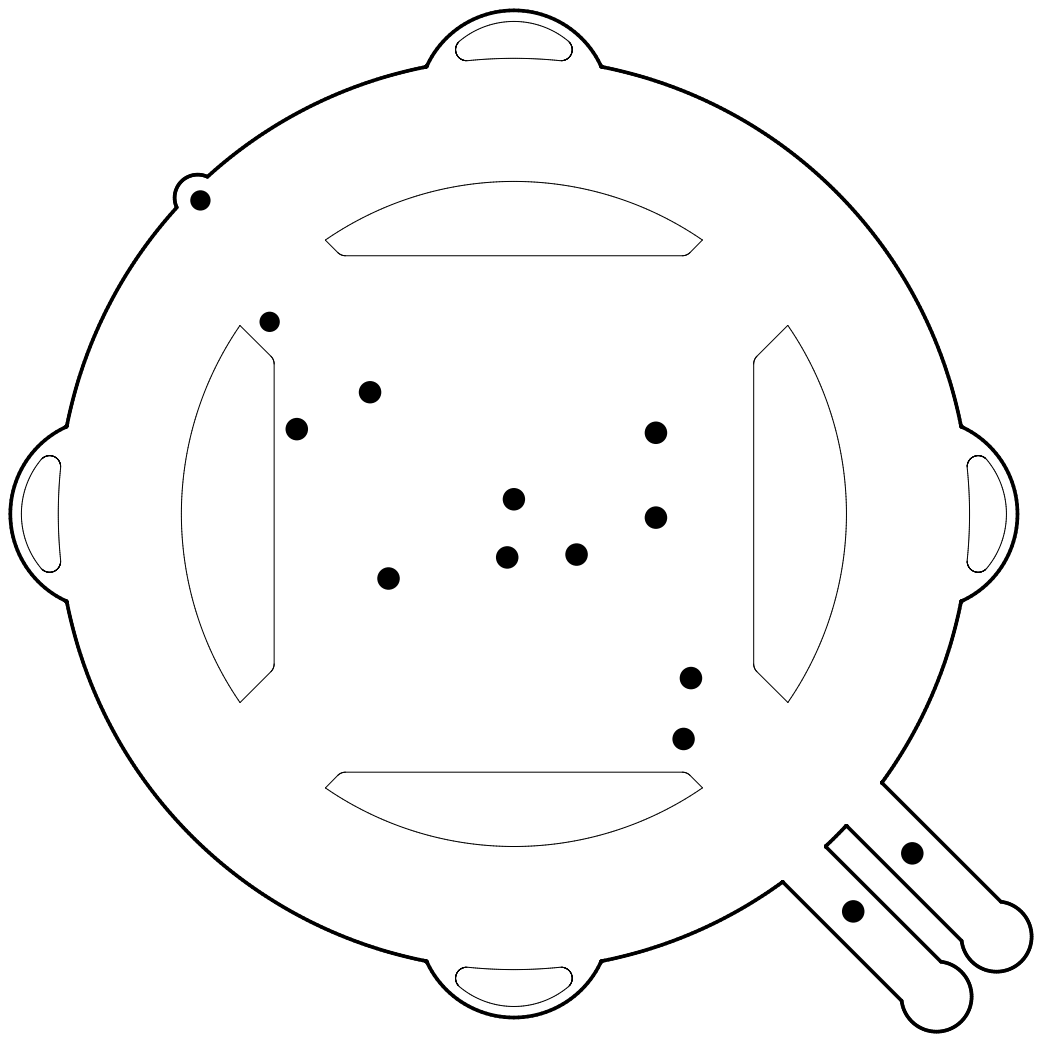
[picture p9: page 1]
