rsheng1001-lang/WPT/FPC线圈叠层图/optimized_v4/WPT_Geometry_Details.pdf

# Receiver FPC · geometry and component detail

Orthographic views from the supplied EDA exports and placement file

Top copper + components | Bottom copper + components | Board outline + cut-outs

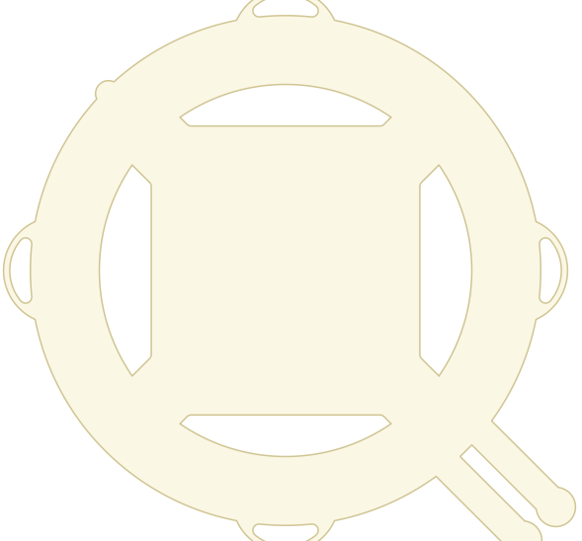
[picture p10: figure]

8 cut-outs; outline taken from Multi-Layer export

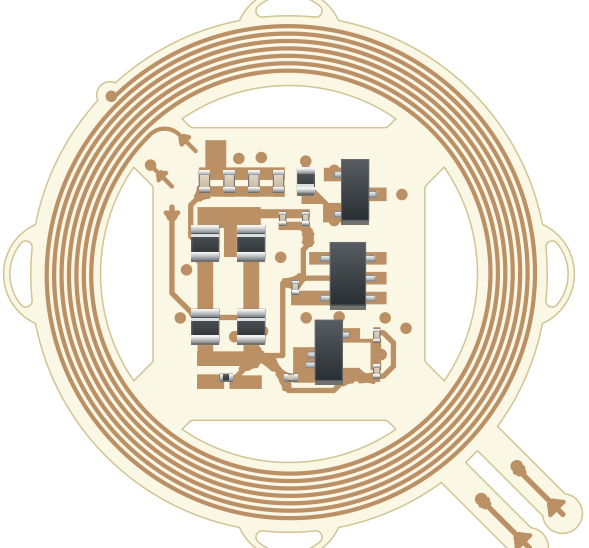
[picture p11: figure]

## Top coverlay · full derived openings

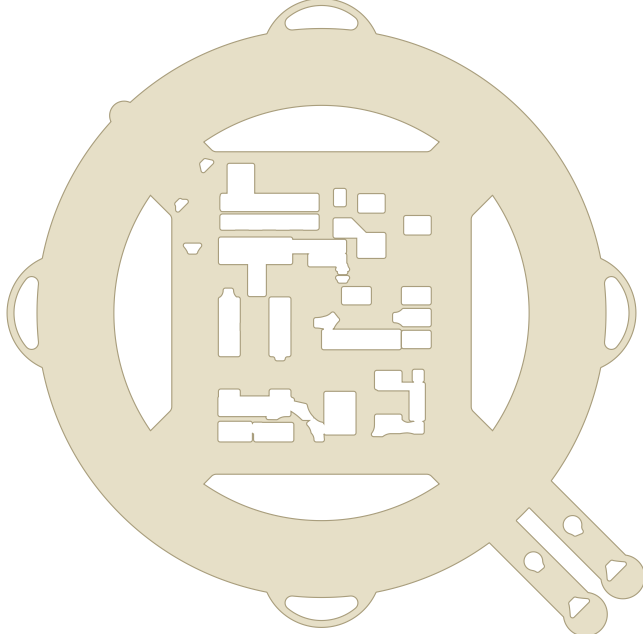
[picture p12: figure]

Pad expansion: 0.1 mm · derived · nominal PI 12.5+15um

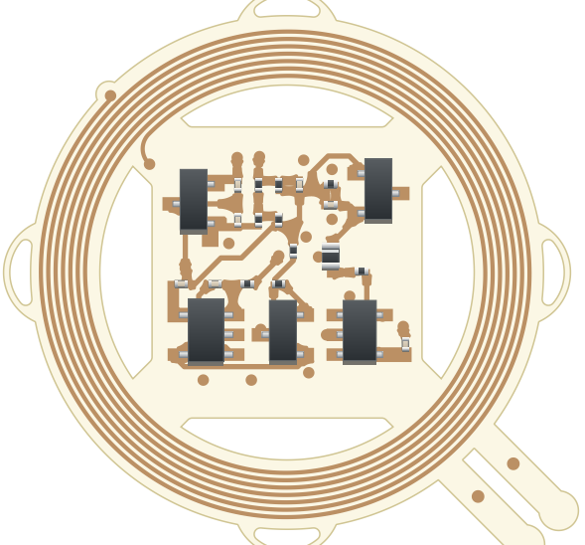
[picture p13: figure]

## Bottom coverlay · full derived openings

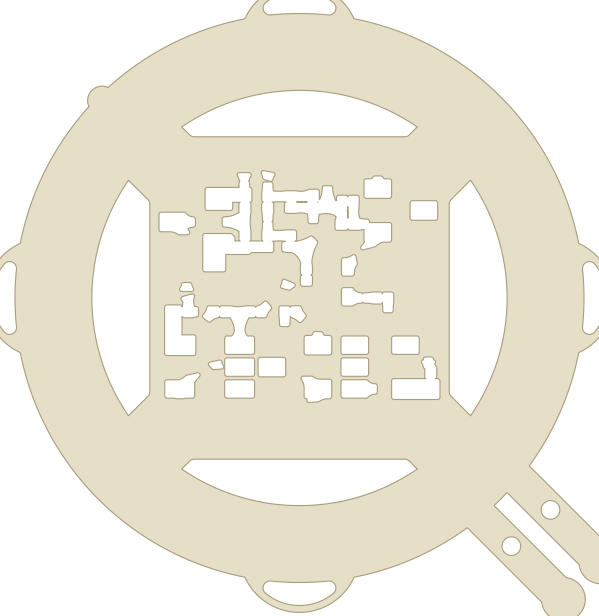
[picture p14: figure]

Pad expansion: 0.1 mm · derived · nominal PI 12.5+15um

### Placement inventory

17 capacitors · 10 resistors · 6 diodes · 3 transistors · 5 U-designated devices

Body sizes follow package definitions; positions and rotations follow the placement CSV.
Existing FPC stack only; no outer encapsulation, as confirmed by the designer.
Copper line widths are projected as filled outlines, keeping coil gaps visible at oblique viewing angles.
