rsheng1001-lang/WPT/self_LPspice/runs_archive/INDEX.md

# runs_archive — 归档索引

本文件由 `archive_run.py` 自动重建，不要手改。每一行对应一个子文件夹，文件夹里是那次运行的完整输出 + `meta.json`。

| # | 文件夹 | 名称 | 运行时刻 | 行数 | RB 范围 | .raw | 入库 |
|---|---|---|---|---|---|---|---|
| 1 | `20260922-192521_Draft2_45e96477` | Draft2 | 2026-09-21 20:07 | 5730 | 10k…200k | 926.7 MB (move) | sweep 1 |
| 2 | `20260922-192522_Draft2_sweep_4bf9238b` | Draft2_sweep | 2026-09-21 22:07 | 2730 | 1Meg…10Meg | 428.1 MB (move) | sweep 3 |

`.raw` 的 action 是 `move` 表示波形已从工程根目录移入本文件夹（LTspice 下次运行会重新生成）；`copy` 表示原位置仍保留一份。
