rsheng1001-lang/WPT/FPC线圈叠层图/optimized_v10/illustrator_details/final.png

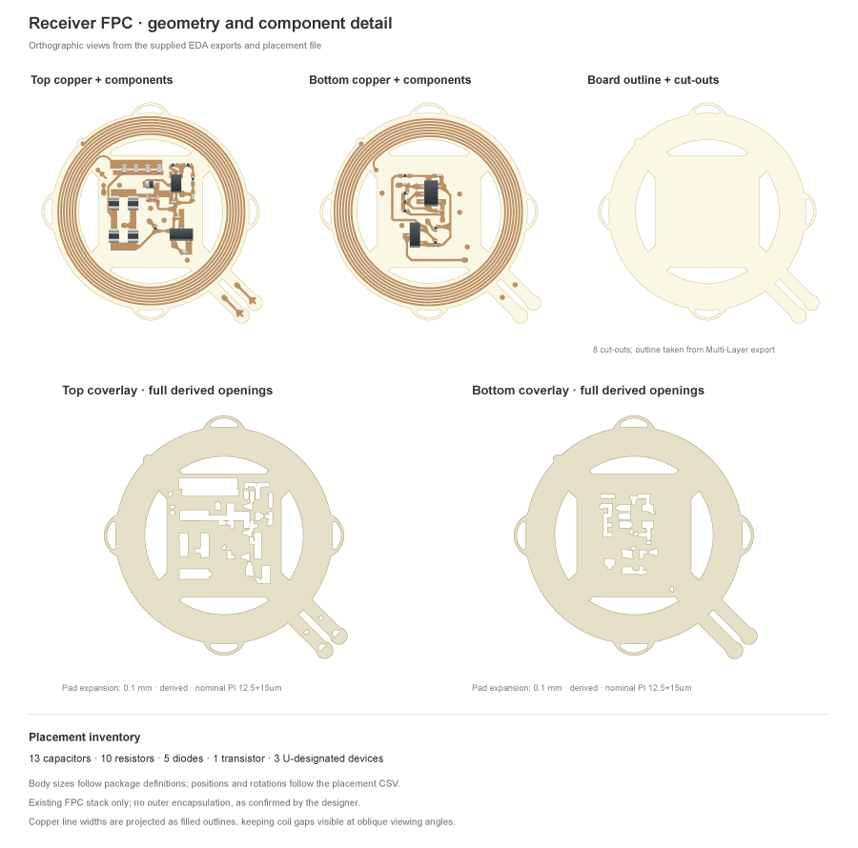
FPC线圈叠层图/optimized_v10/illustrator_details/final.png
