rsheng1001-lang/WPT/FPC线圈叠层图/optimized_v10_horizontal/illustrator_main/final.png

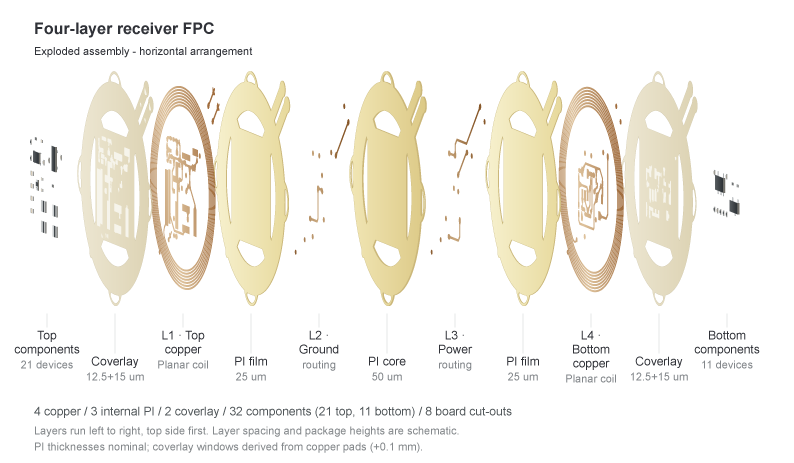
FPC线圈叠层图/optimized_v10_horizontal/illustrator_main/final.png
