rsheng1001-lang/WPT/self_LPspice/bone_sweep_analysis/charts/Charts_1.png

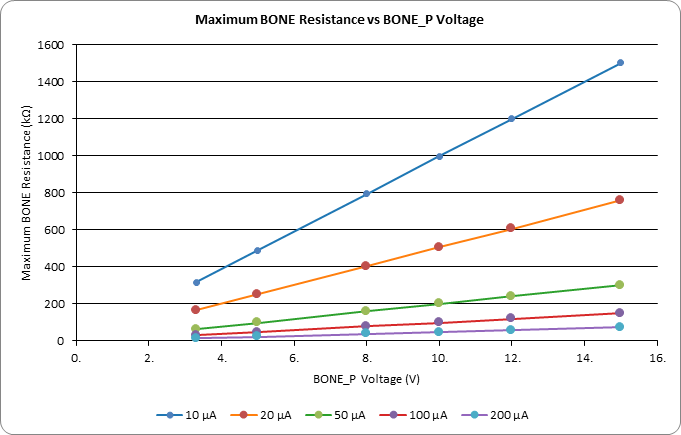
self_LPspice/bone_sweep_analysis/charts/Charts_1.png
