rsheng1001-lang/WPT/self_LPspice/bone_sweep_analysis/charts/Charts_I_vs_R_1.png

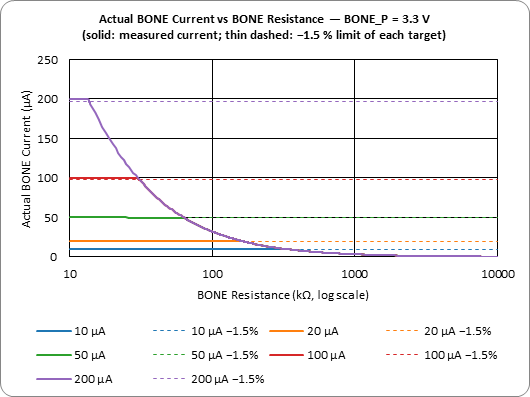
self_LPspice/bone_sweep_analysis/charts/Charts_I_vs_R_1.png
