rsheng1001-lang/WPT/FPC线圈叠层图/inputs/BOM.pdf

No. | Quantity | Comment | Designator | Footprint | Value | Manufacturer Part | Manufacturer | Supplier Part | Supplier
1 | 4 | 100nF | C1,C2,C3,C4 | C0402 | 100nF | CL05B104KB 54PNC | SAMSUNG( ) 三星 | C307331 | LCSC
2 | 2 | 1uF | C5,C10 | C0201 | 1uF | GRM033R60 J105MEA2D | muRata(村田 ) | C76930 | LCSC
3 | 3 | 100nF | C6,C12,C13 | C0201 | 100nF | GRM033R61 E104KE14D | muRata(村田 ) | C76939 | LCSC
4 | 2 | 100nF | C7,C9 | C0201 | 100nF | GRM033R60 J105MEA2D | muRata(村田 ) | | LCSC
5 | 1 | 0.47uF | C8 | C0201 | 0.47uF | GRM033R60 J105MEA2D | muRata(村田 ) | | LCSC
6 | 1 | 100pF | C14 | C0201 | 100pF | GRM0335C1 H101JA01D | muRata(村田 ) | C76922 | LCSC
7 | 4 | 1N5819WS | D1,D2,D3,D4 | SOD-323_L1 .6-W1.3-LS2. 6-RD-1 | | 1N5819WS | GOODWOR K(固得沃克 ) | C2903903 | LCSC
8 | 1 | VESD16C1-0 2V-G3-08 | D5 | SOD-523_L1 .2-W0.8-LS1. 6-FD | | VESD16C1-0 2V-G3-08 | VISHAY(威世 ) | C1974489 | LCSC
9 | 1 | 2N7002 | Q1 | SOT-23-3_L2 .9-W1.3-P1.9 0-LS2.4-BR | | 2N7002 | TWGMC( 迪 嘉 ) | C727149 | LCSC
10 | 1 | 560k | R1 | R0201 | 560k | 0201WMF10 01TEE | UNI-ROYAL( 厚声 ) | | LCSC
11 | 1 | 6.8k | R2 | R0201 | 6.8k | 0201WMF10 01TEE | UNI-ROYAL( 厚声 ) | | LCSC
12 | 1 | 100k | R3 | R0201 | 100k | 0201WMF10 01TEE | UNI-ROYAL( 厚声 ) | | LCSC
13 | 1 | 0 | R4 | R0201 | 0 | 0201WMF00 00TEE | UNI-ROYAL( ) 厚声 | C473473 | LCSC
14 | 1 | 100k | R5 | R0201 | 100k | 0805W8F200 3T5E | UNI-ROYAL( ) 厚声 | | LCSC
15 | 2 | 10k | R6,R8 | R0201 | 10k | 0201WMF10 02TEE | UNI-ROYAL( 厚声 ) | C473048 | LCSC
16 | 1 | 10k | R7 | R0201 | 10k | RC-01W2001 FT | FH(风华 ) | | LCSC
17 | 1 | 10M | R9 | R0201 | 10M | RC0201JR-0 71ML | YAGEO(国巨 ) | | LCSC
18 | 1 | 3k | R10 | R0201 | 3k | 0201WMF10 01TEE | UNI-ROYAL( ) 厚声 | | LCSC
19 | 1 | ST715CR | U1 | SOT-323-5_L 2.1-W1.3-P0. 65-LS2.1-BL | | ST715CR | ST(意法半导 体) | C3748933 | LCSC
20 | 1 | MCP1703AT-3302E/CB | U2 | SOT-23-3_L2 .9-W1.3-P1.9 0-LS2.4-BR | | MCP1703AT-3302E/CB | MICROCHIP( ) 美国微芯 | C144183 | LCSC
21 | 1 | OPA333AID BVR | U3 | SOT-23-5_L3 .0-W1.7-P0.9 5-LS2.8-BR | | OPA333AID BVR | TI(德州仪器 ) | C30878 | LCSC
