rsheng1001-lang/WPT/self_LPspice/bone_sweep_analysis/figures/fig1_rmax_design_rule.pdf

a | Design rule: usable load range
b | Agreement with the design rule

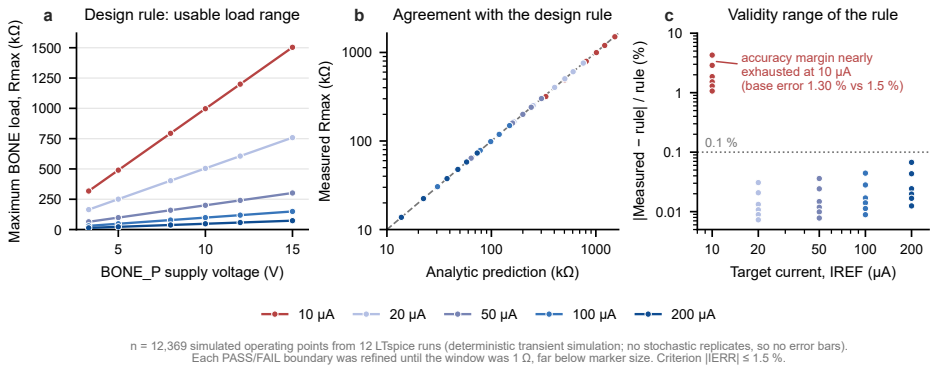
[picture p24: page 1]
BONE_P supply voltage (V); Measured Rmax (k; Validity range of the rule

Maximum BONE load, Rmax (k

Measured − rule| / rule (%)

accuracy margin nearly
exhausted at 10 µA
(base error 1.30 % vs 1.5 %)

Analytic prediction (kΩ)

Target current, IREF (µA)

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
