rsheng1001-lang/WPT/FPC线圈叠层图/optimized_v10/WPT_Exploded_Refined.pdf

# Four-layer receiver FPC

## Top components

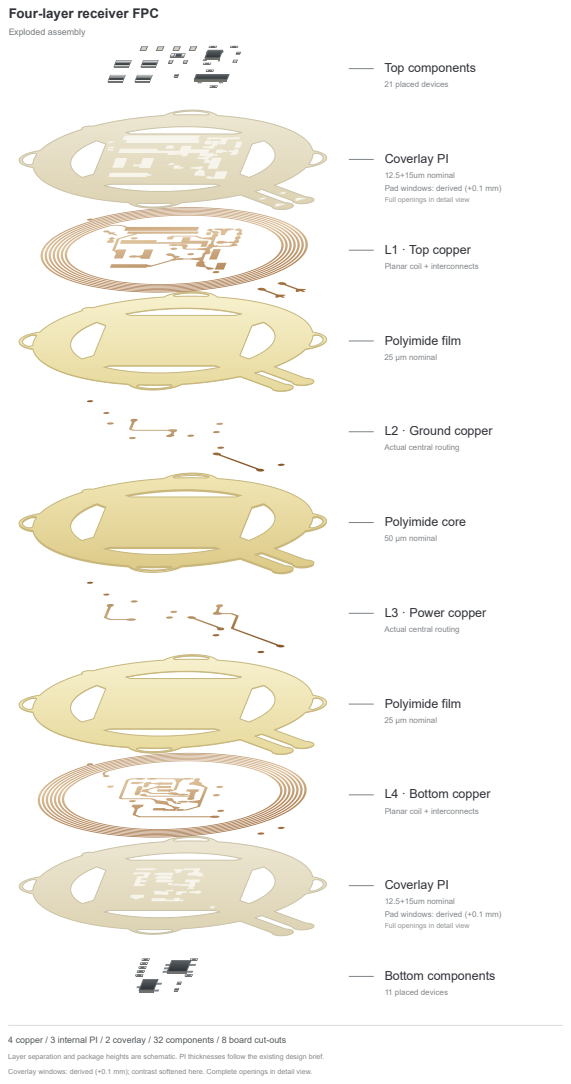
[picture p26: page 1]
Exploded assembly; 21 placed devices; Polyimide film; 25 µm nominal; Polyimide core; 50 µm nominal; Bottom components; 11 placed devices

Coverlay PI
12.5+15um nominal
Pad windows: derived (+0.1 mm)
Full openings in detail view

L1 · Top copper
Planar coil + interconnects

L2 · Ground copper
Actual central routing

L3 · Power copper

L4 · Bottom copper

4 copper / 3 internal PI / 2 coverlay / 32 components / 8 board cut-outs
Layer separation and package heights are schematic. PI thicknesses follow the existing design brief.
Coverlay windows: derived (+0.1 mm); contrast softened here. Complete openings in detail view.
