rsheng1001-lang/WPT/FPC线圈叠层图/optimized_v10_compact/WPT_Exploded_Refined.pdf

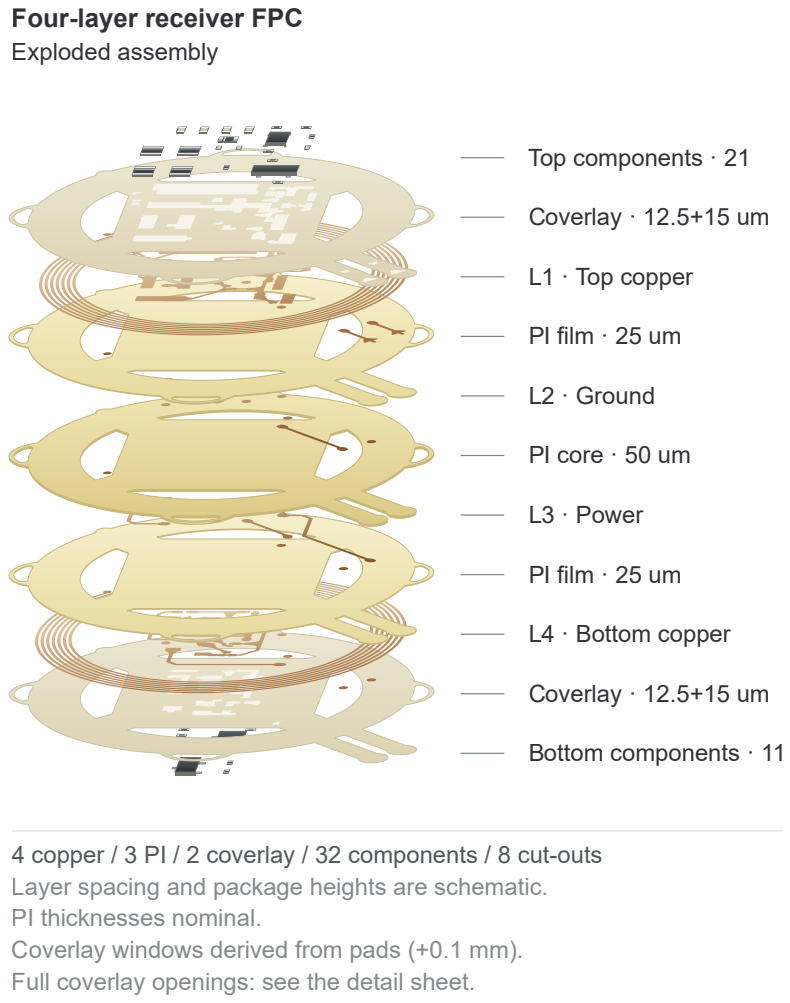
[picture p27: page 1]

Four-layer receiver FPC
Exploded assembly

Top components · 21
Coverlay · 12.5+15 um
L1 · Top copper
PI film · 25 um
L2 · Ground
PI core · 50 um
L3 · Power
L4 · Bottom copper
Bottom components · 11

4 copper / 3 PI / 2 coverlay / 32 components / 8 cut-outs
Layer spacing and package heights are schematic.
PI thicknesses nominal.
Coverlay windows derived from pads (+0.1 mm).
Full coverlay openings: see the detail sheet.
