rsheng1001-lang/WPT/FPC线圈叠层图/optimized_v10_horizontal/WPT_Exploded_Refined.pdf

## Four-layer receiver FPC

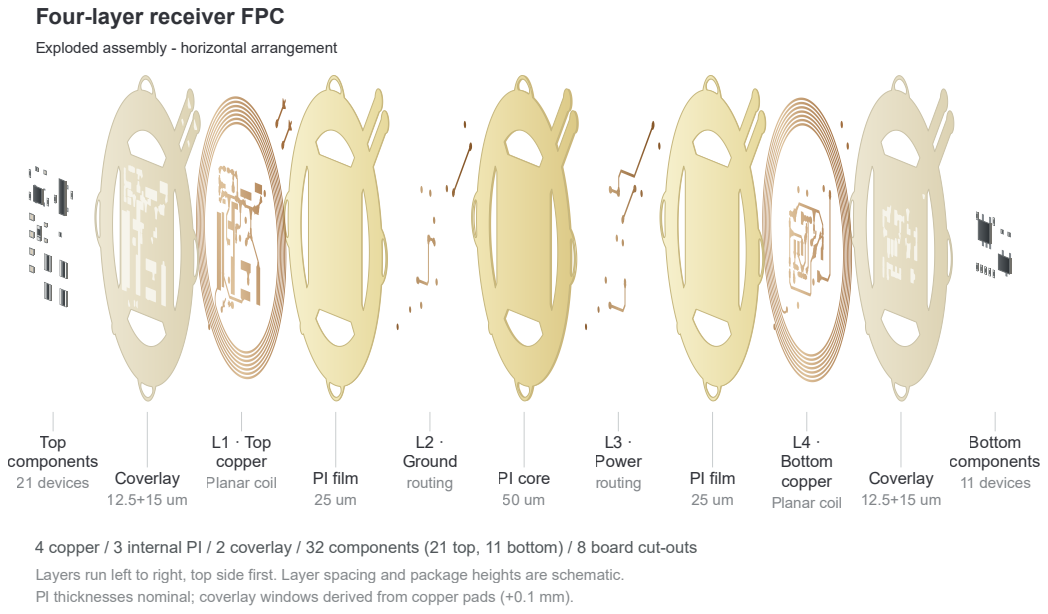
[picture p28: page 1]
Top components; 21 devices; Coverlay; L1 · Top copper; Planar coil; PI film; L2 · Ground; routing; PI core; L3 · Power; L4 · Bottom copper Planar coil; Coverlay 12.5+15 um; Bottom components 11 devices

Exploded assembly - horizontal arrangement

4 copper / 3 internal PI / 2 coverlay / 32 components (21 top, 11 bottom) / 8 board cut-outs
Layers run left to right, top side first. Layer spacing and package heights are schematic.
PI thicknesses nominal; coverlay windows derived from copper pads (+0.1 mm).
