rsheng1001-lang/WPT/self_LPspice/bone_sweep_analysis/figures/fig2_compliance_limit.pdf

a | BONE_P = 3.3 V | b | BONE_P = 5 V | c | BONE_P = 8 V

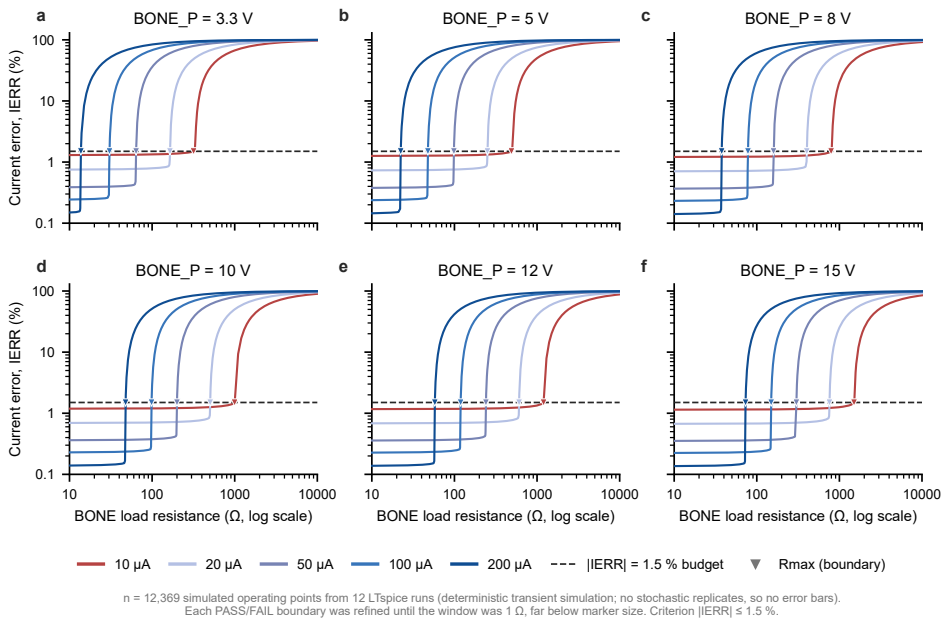
[picture p29: page 1]
BONE_P = 10 V; BONE_P = 12 V; BONE_P = 15 V; |IERR| = 1.5 % budget; Rmax (boundary)

Current error, IERR (%)

BONE load resistance (Ω, log scale)

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
