rsheng1001-lang/WPT/FPC线圈叠层图/optimized_v10_paper/landscape/WPT_Exploded_Refined.pdf

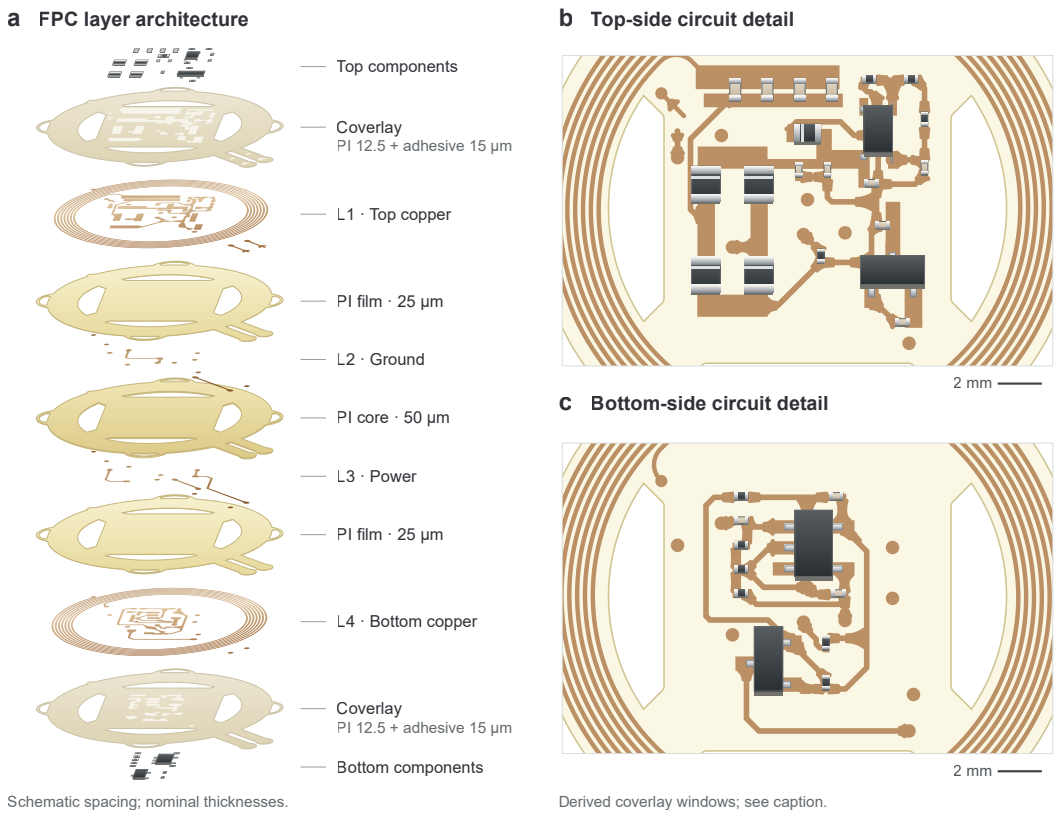
[picture p30: page 1]
a FPC layer architecture; b Top-side circuit detail; Top components; L1 · Top copper; L2 · Ground; L3 · Power; L4 · Bottom copper; Schematic spacing; nominal thicknesses.; Derived coverlay windows; see caption.

Coverlay
PI 12.5 + adhesive 15 µm

PI film · 25 µm

c Bottom-side circuit detail

PI core · 50 µm

Bottom components
