rsheng1001-lang/WPT/FPC线圈叠层图/inputs/装配/Bottom Assembly Layer.pdf

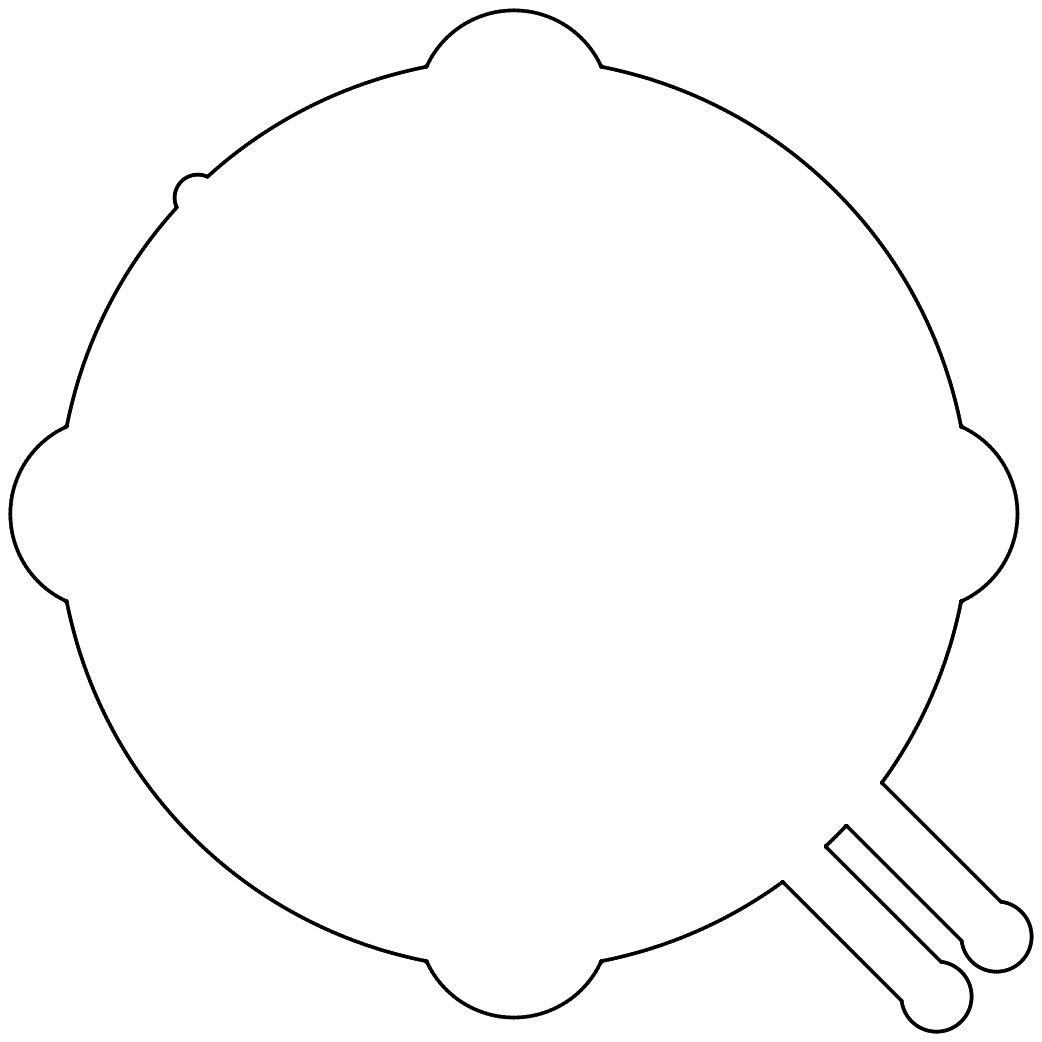
[picture p31: page 1]
