rsheng1001-lang/WPT/LPspice_circuit/SCH_接收端原理图_2026-09-20.pdf

C0G

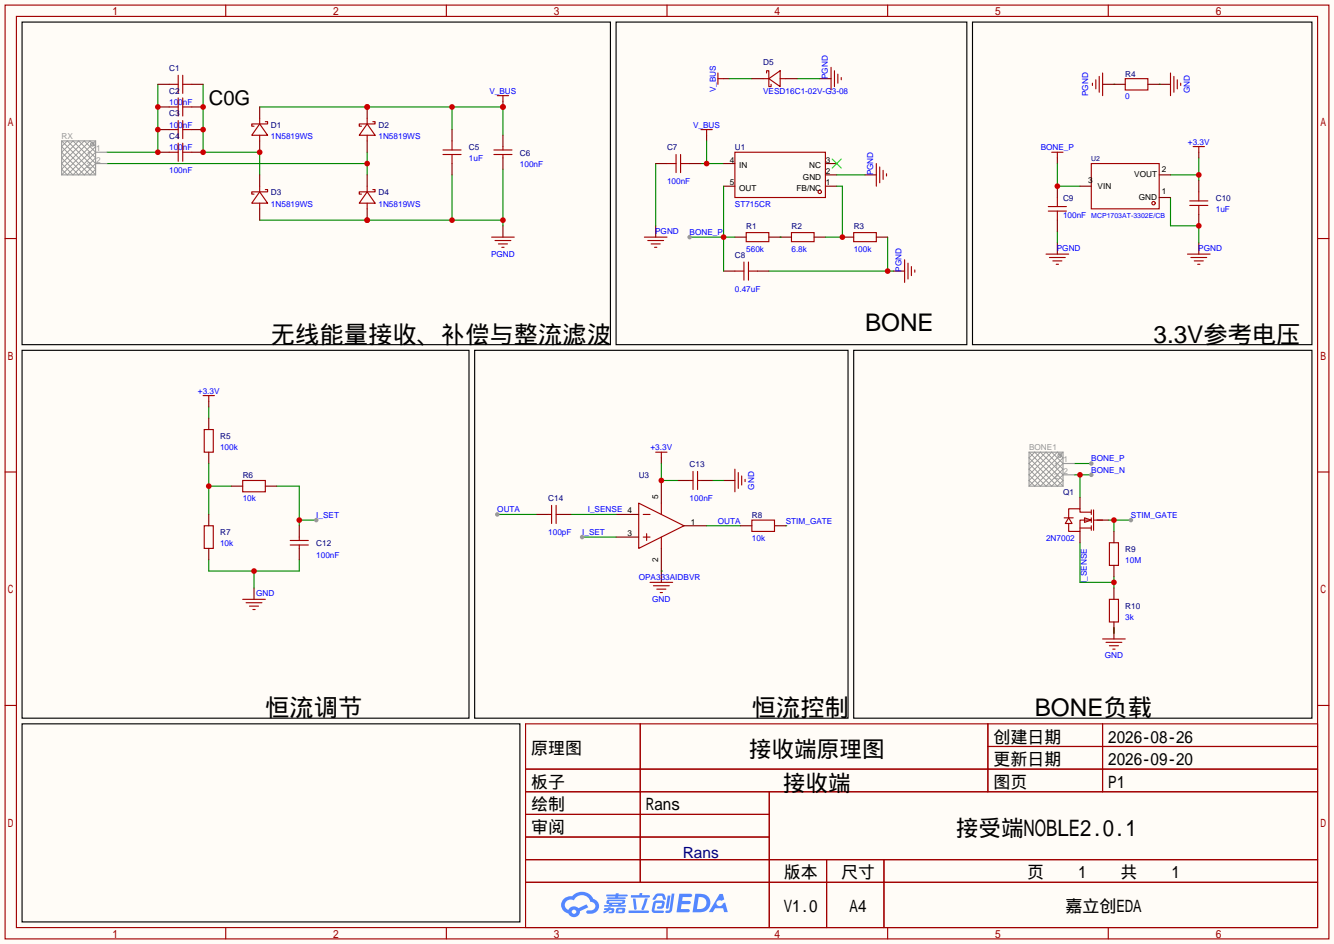
[picture p32: page 1]

原理图 | 接收端原理图 | 创建日期 | 2026-08-26

更新日期 | 2026-09-20

板子 | 接收端 | 图页 | P1
绘制 | Rans | 接受端NOBLE2.0.1
审阅

Rans

V1.0 | A4 | 嘉立创EDA
