rsheng1001-lang/WPT/FPC线圈叠层图/inputs/底面自动位号图.pdf

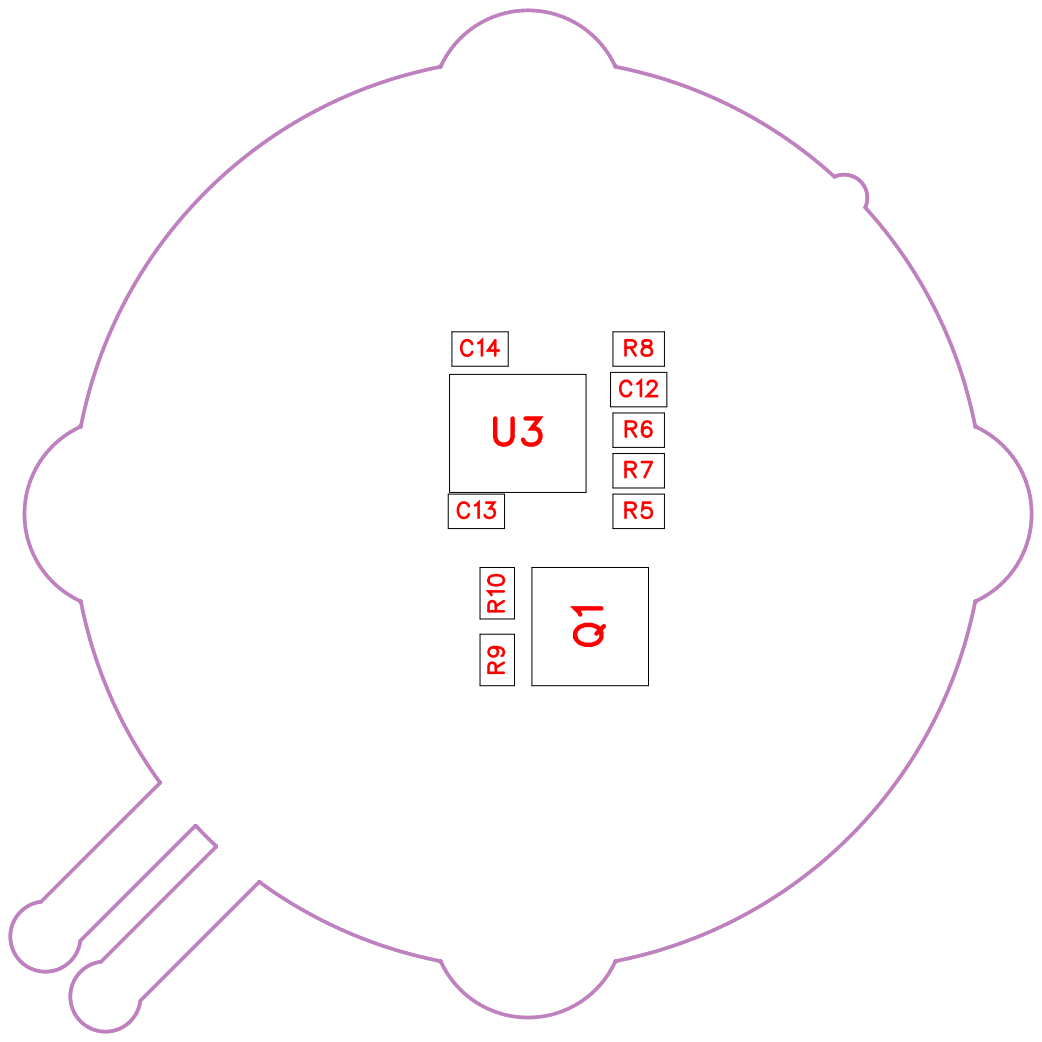
[picture p33: page 1]
