rsheng1001-lang/WPT/FPC线圈叠层图/inputs/顶面自动位号图.pdf

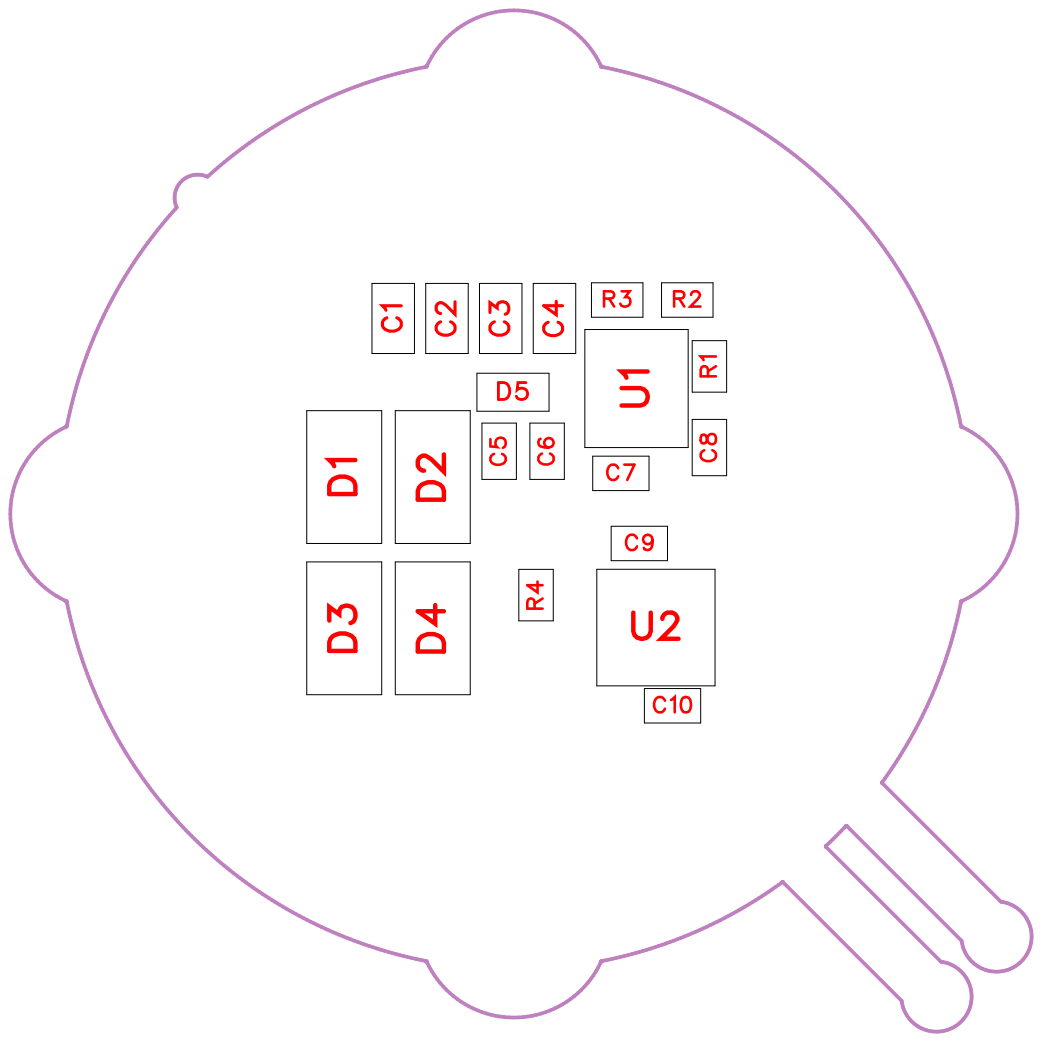
[picture p34: page 1]
