rsheng1001-lang/WPT/FPC线圈叠层图/inputs/BUTTON/Bottom Layer.pdf

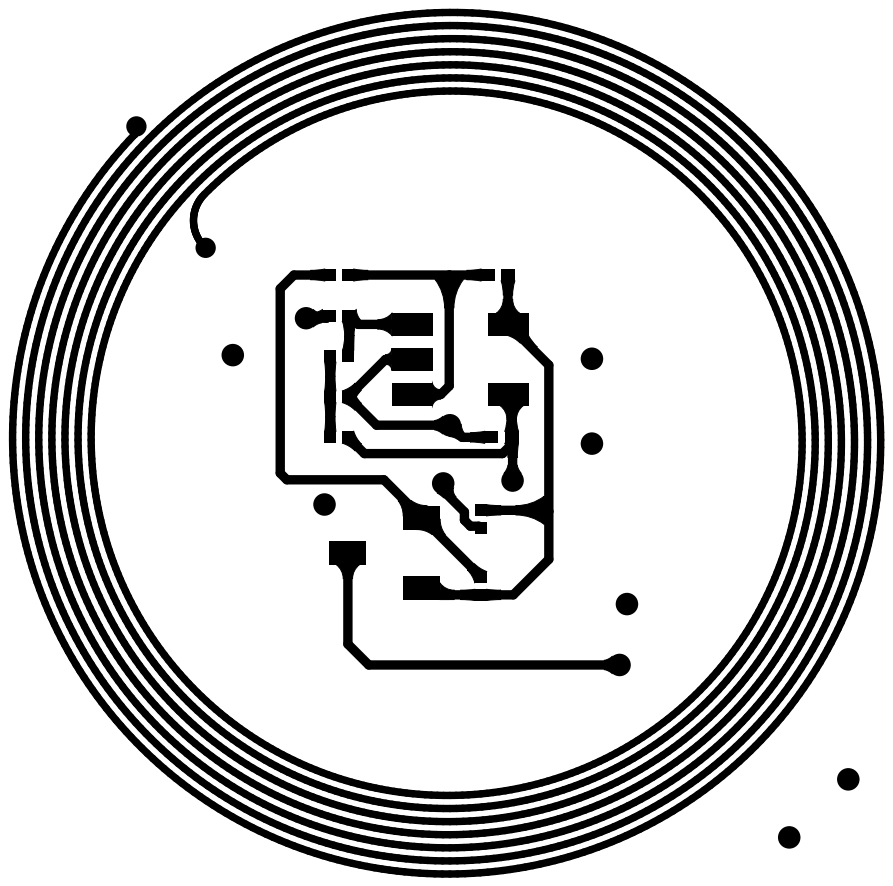
[picture p35: page 1]
