rsheng1001-lang/WPT/FPC线圈叠层图/inputs/TOP/Top Layer.pdf

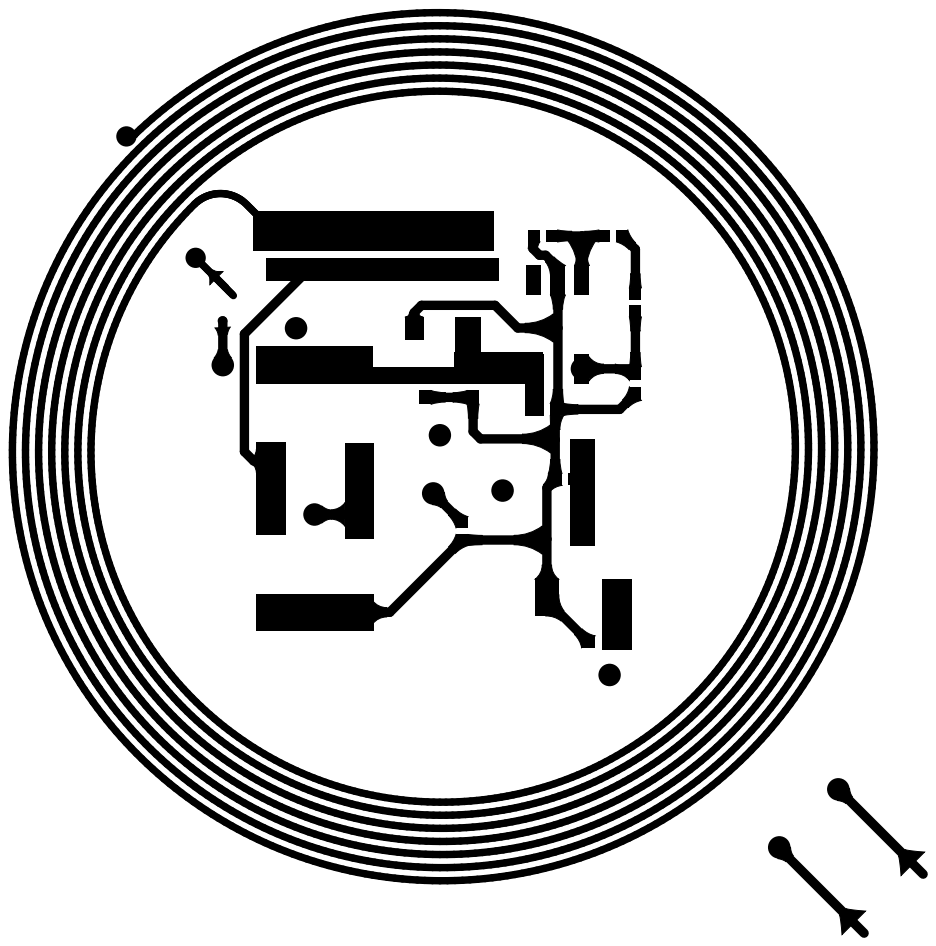
[picture p36: page 1]
