rsheng1001-lang/WPT/FPC线圈叠层图/inputs/板框/Hole Layer.pdf

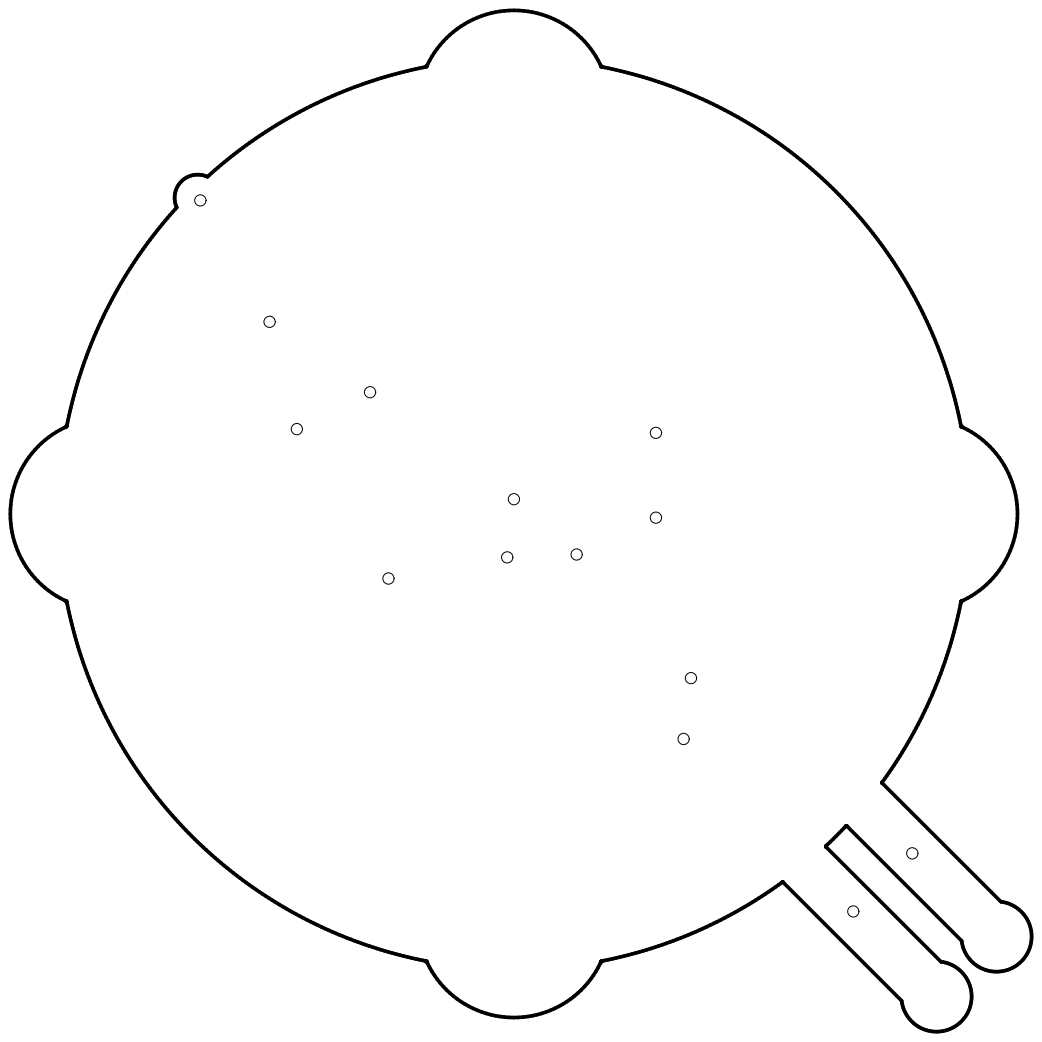
[picture p37: page 1]
