rsheng1001-lang/WPT/self_LPspice/Draft2.asc

C1: cap; 1e-7
C2: cap; 4.7e-7
C3: cap; 1e-7
C14: cap; 100pF
R1: res; 560k
R2: res; 6.8k
R3: res; 100k
R5: res; {10k*(3.3/(IREF*3k)-1)}
R6: res; 10k
R7: res; 10k
R8: res; 10k
R9: res; 10Meg
R10: res; 3k
R_BONE: res; {RB}
U1: opamp2; OPAx333
U2: T2N7002AK_G0_00
V1: voltage; 12
V2: voltage; {VBP}
V3: voltage; 3.3
Named nets: BUS, 0, BONE_P, FB, I_SET, I_SENSE, OUTA, 3V3, STIM_GATE, BONE_N
.lib OPAx333.LIB
.param IREF 100u
.step param VBP list 3.3 5 8 10 12 15
.step param RB list 10k 20k 30k 40k 50k 60k 70k 80k 100k 120k 150k
.meas OP IBONE FIND -I(R_BONE)
.meas OP VBONE FIND V(BONE_P,BONE_N)
.meas OP IERR PARAM 100*abs(IBONE-IREF)/IREF
.meas OP PASS PARAM if(IERR<=1,1,0)
.tran 15m startup
