rsheng1001-lang/WPT/self_LPspice/Draft2_sweep.asc

C1: cap; 1e-7
C2: cap; 4.7e-7
C3: cap; 1e-7
C14: cap; 100pF
R1: res; 560k
R2: res; 6.8k
R3: res; 100k
R5: res; {R5SET}
R6: res; 10k
R7: res; 10k
R8: res; 10k
R9: res; 10Meg
R10: res; 3k
R_BONE: res; {RB}
U1: UniversalOpAmp2; Avol=3.16Meg GBW=350k Slew=160k; Ilimit=5m Rail=50m Vos=2u
U2: T2N7002AK_G0_00
V1: voltage; 12
V2: voltage; {VBP}
V3: voltage; 3.3
Named nets: BUS, 0, BONE_P, FB, I_SET, I_SENSE, OUTA, 3V3, STIM_GATE, BONE_N
.meas tran IBONE AVG -I(R_BONE) FROM 12m TO 15m
.meas tran VBONE AVG V(BONE_P,BONE_N) FROM 12m TO 15m
.meas tran IERR PARAM 100*abs(IBONE-IREF)/IREF
.meas tran PASS PARAM if(IERR<=1,1,0)
.tran 15m startup
.param R5SET=10k*(3.3/(IREF*3k)-1)
.step param IREF list 10u 20u 50u 100u 200u
.step param RB 10k 200k 1k
.step param VBP list 3.3 5 8 10 12 15
