rsheng1001-lang/WPT/LPspice_circuit/ltspice/full_bus.asc

C5: cap; 1u
C6: cap; 100n
C7: cap; 100n
C8: cap; 470n
C9: cap; 100n
C10: cap; 1u
C12: cap; 100n
C13: cap; 100n
C14: cap; 100p
D5: VESD16_APPROX
Q1: N7002
R1: res; 560k
R2: res; 6.8k
R3: res; 100k
R4: res; 1m
R5: res; 100k
R6: res; 10k
R7: res; 10k
R8: res; 10k
R9: res; 10Meg
R10: res; 3k
R_BONE: res; 10k
U1: ST715_APPROX
U2: MCP1703A33_APPROX
U3: OPAx333
VBUS: voltage; 12
Named nets: V_BUS, PGND, BONE_P, FB_TOP, FB, V3V3, 0, DIV, I_SET, OUTA, STIM_GATE, I_SENSE, BONE_N
.include models/OPAx333.LIB
.include models/2N7002_DIODES.lib
.include models/APPROX_NOT_VENDOR.lib
.include inc/solver.inc
.dc VBUS 4 16 0.25
.save V(V_BUS) V(BONE_P) V(V3V3) V(I_SET) V(I_SENSE) V(OUTA) V(BONE_N) I(R_BONE) I(VBUS)
.options plotwinsize=0 numdgt=7
