rsheng1001-lang/WPT/LPspice_circuit/ltspice/sink_vendor.asc

C12: cap; 100n
C13: cap; 100n
C14: cap; 100p
Q1: N7002
R5: res; 100k
R6: res; 10k
R7: res; 10k
R8: res; 10k
R9: res; 10Meg
R10: res; 3k
R_BONE: res; 10k
U3: OPAx333
V8: voltage; 8.0016
V33: voltage; 3.3
Named nets: DIV, 0, V3V3, I_SET, OUTA, STIM_GATE, I_SENSE, BONE_P, BONE_N
.include models/OPAx333.LIB
.include models/2N7002_DIODES.lib
.include inc/solver.inc
.op
.save V(V3V3) V(BONE_P) V(BONE_N) V(I_SET) V(I_SENSE) V(OUTA) V(STIM_GATE) I(R_BONE) I(R10)
.options plotwinsize=0 numdgt=7
