rsheng1001-lang/WPT/(list of files, drawings)

Other design files:
self_LPspice/OPA333/OPAx333.OLB
self_LPspice/OPA333/OPAx333_Test_Circuit.DSN
self_LPspice/OPA333/OPAx333_Test_Circuit.OPJ
