rsheng1001-lang/WPT/(commit log)

2026-09-22 Initial commit: FPC stackup, LPspice circuits, bone sweep analysis (exclude *.raw waveforms and Coil standalone repo)
    [BONE_10k_5V8V_IREF_grid.csv, BONE_10k_5V8V_IREF_grid_Req_analysis.xlsx, BONE_30k_5V8V_IREF_grid.csv, BONE_30k_5V8V_IREF_grid_Req_analysis.xlsx, BONE_5V100uA_Req_analysis.xlsx, BONE_5V100uA_curve.csv, BONE_8V100uA_Req_analysis.xlsx, BONE_8V100uA_curve.csv]
2026-09-22 清理生成文件：.ltspice-mcp, refine decks, 日志/db, work 聚合产物, tiff/QA 图, ltspice Data（保留 runs_archive/work 快照与交付图）
    [BONE_10k_5V8V_IREF_grid.csv, BONE_10k_5V8V_IREF_grid_Req_analysis.xlsx, BONE_30k_5V8V_IREF_grid.csv, BONE_30k_5V8V_IREF_grid_Req_analysis.xlsx, BONE_5V100uA_Req_analysis.xlsx, BONE_5V100uA_curve.csv, BONE_8V100uA_Req_analysis.xlsx, BONE_8V100uA_curve.csv]
2026-09-22 归档工作点op.raw纳入跟踪；忽略根目录误落的summary.txt
2026-09-22 更新 full_bus/sink_vendor 原理图与网表
